duoshock/UM-70/README.md

# UM-70

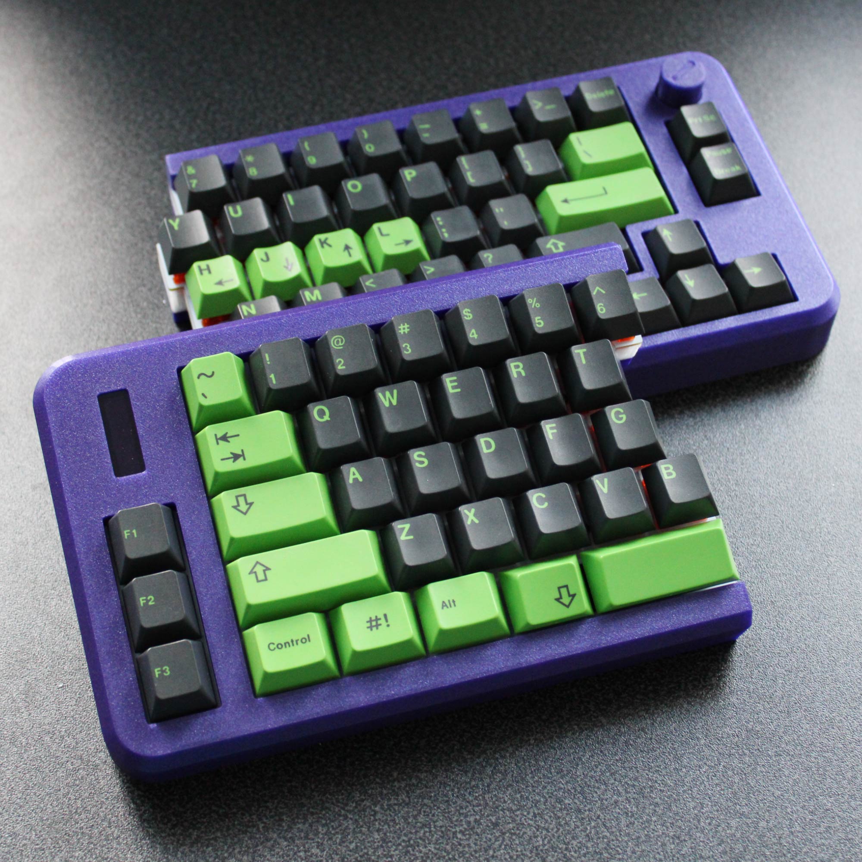
[picture p1: Assembly Guide/images/um70_extra_thumb.jpg]


UM-70 is a split keyboard in 65% layout with RGB, macro keys, OLED screen and encoder housed in PLA 3D printed cases sold by [Merge](https://mergedesign.store/products/um-70-r2).
