duoshock/UM-70/Print Guide/STLs/Cases/UM70_L_R2v1.STL

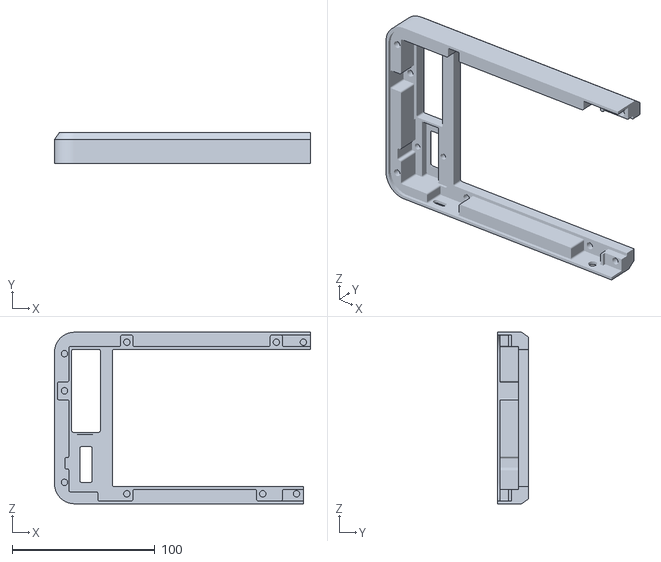
[picture p2: CAD file, 2022-07-18]
Print Guide/STLs/Cases/UM70_L_R2v1.STL
179.4 x 22.0 x 120.2
