duoshock/UM-70/Print Guide/STLs/Covers/UM70_R_Cover_R2v1.STL

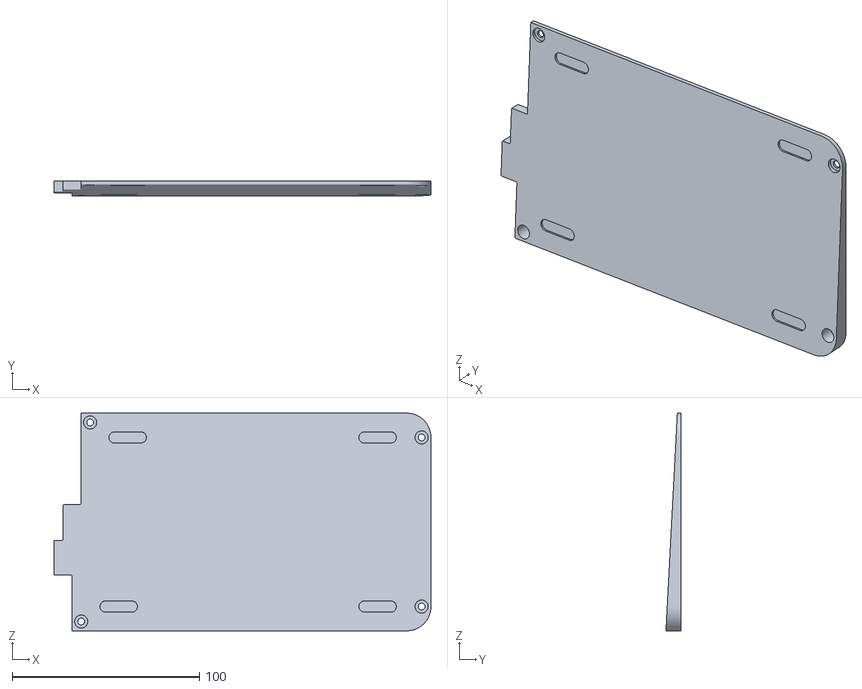
[picture p3: CAD file, 2022-10-08]
Print Guide/STLs/Covers/UM70_R_Cover_R2v1.STL
201.1 x 8.09 x 116.2
