duoshock/UM-70/Print Guide/STLs/Panels/UM70_L_Panel_R2v1.STL

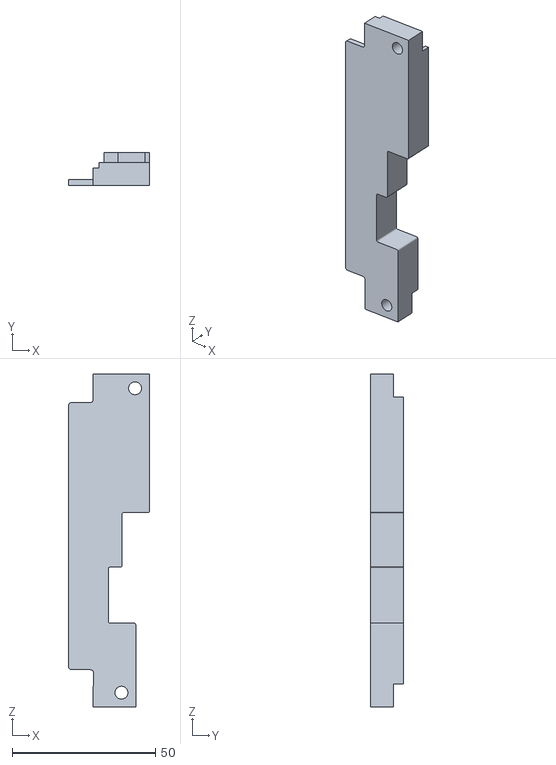
[picture p4: CAD file, 2022-10-08]
Print Guide/STLs/Panels/UM70_L_Panel_R2v1.STL
28.2 x 11.4 x 116.2
