duoshock/UM-70/Print Guide/STLs/Plates/UM70_L_Plate_v7.STEP

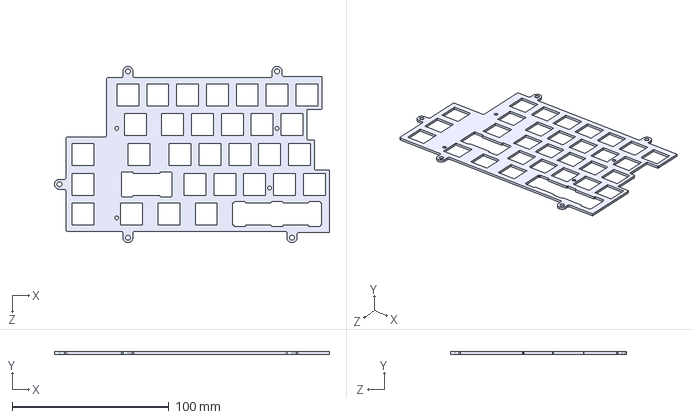
[picture p5: CAD file, 2023-09-09]
Print Guide/STLs/Plates/UM70_L_Plate_v7.STEP
175.6 x 1.60 x 112.6 mm
