duoshock/UM-70/Print Guide/STLs/Raisers - 4 Degree/UM70_L_Raiser_4Degree_R2v1.STL

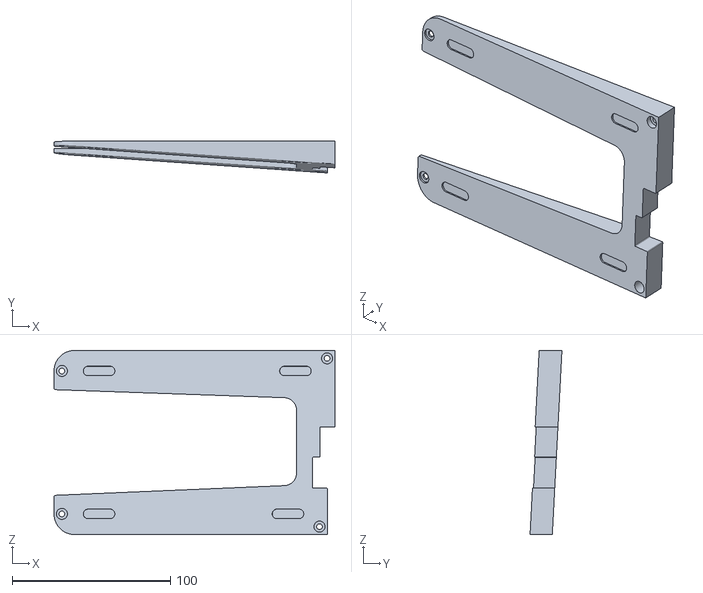
[picture p6: CAD file, 2022-10-08]
Print Guide/STLs/Raisers - 4 Degree/UM70_L_Raiser_4Degree_R2v1.STL
177.3 x 20.2 x 116.2
