duoshock/UM-70/Print Guide/STLs/Raisers - 6 Degree/UM70_R_Raiser_6Degree_R2v1.STL

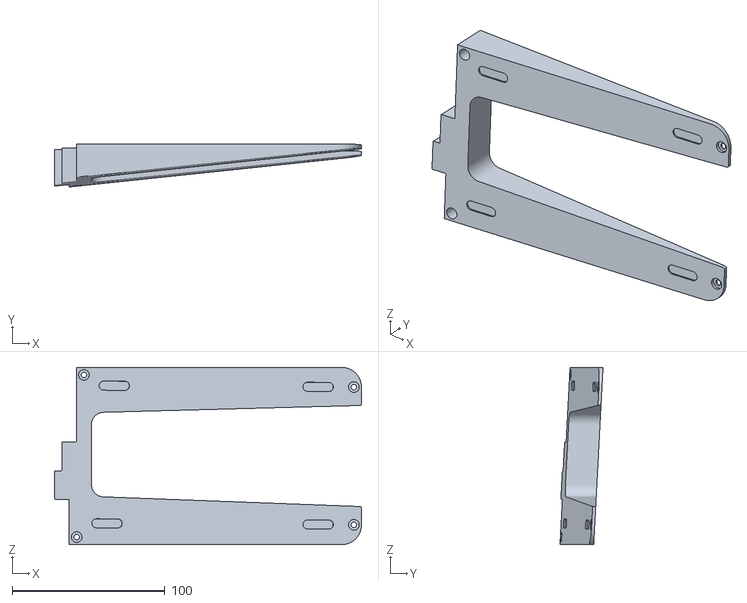
[picture p7: CAD file, 2022-10-08]
Print Guide/STLs/Raisers - 6 Degree/UM70_R_Raiser_6Degree_R2v1.STL
201.1 x 28.2 x 116.2
