duoshock/UM-70/Print Guide/STLs/UM70_Knob_v1.stl

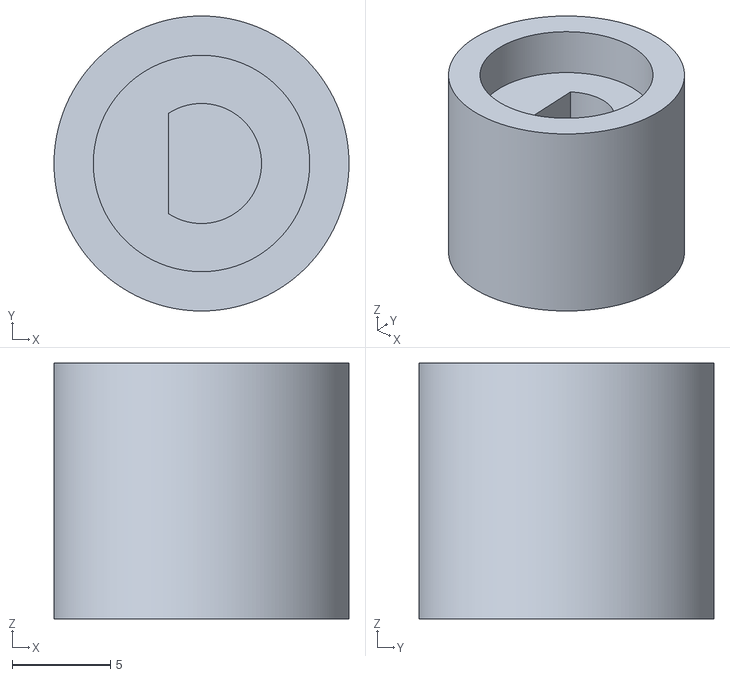
[picture p8: CAD file, 2025-07-31]
Print Guide/STLs/UM70_Knob_v1.stl
15.0 x 15.0 x 13.0
