duoshock/UM-70/Print Guide/STLs/Cases/UM70_R_R2v1.STL

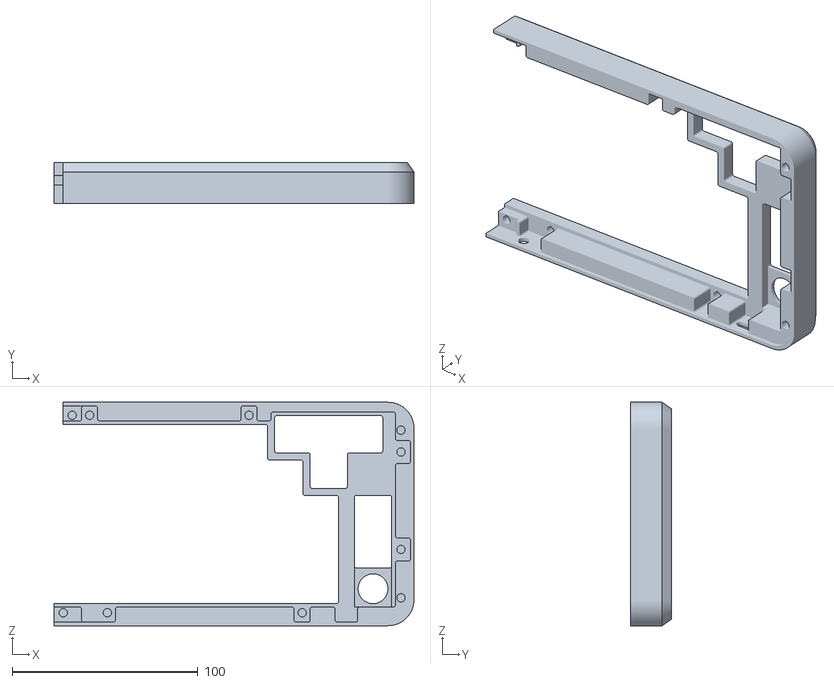
[picture p9: CAD file, 2022-07-18]
Print Guide/STLs/Cases/UM70_R_R2v1.STL
193.6 x 22.0 x 120.2
