duoshock/UM-70/Print Guide/STLs/Covers/UM70_L_Cover_R2v1.STL

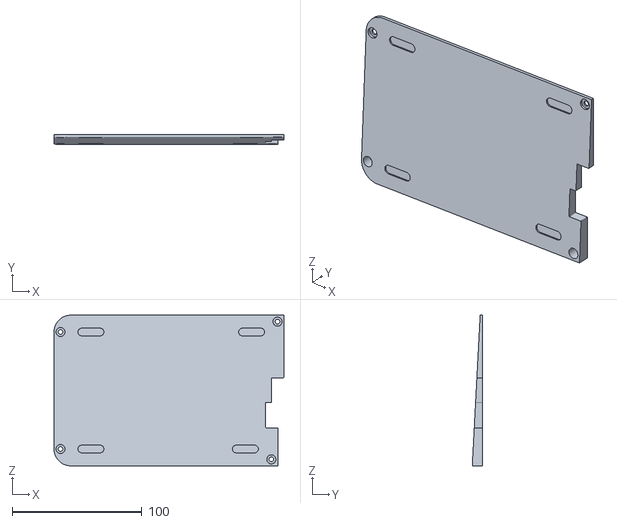
[picture p10: CAD file, 2022-10-08]
Print Guide/STLs/Covers/UM70_L_Cover_R2v1.STL
177.3 x 8.09 x 116.2
