duoshock/UM-70/Print Guide/STLs/Panels/UM70_R_Panel_R2v1.STL

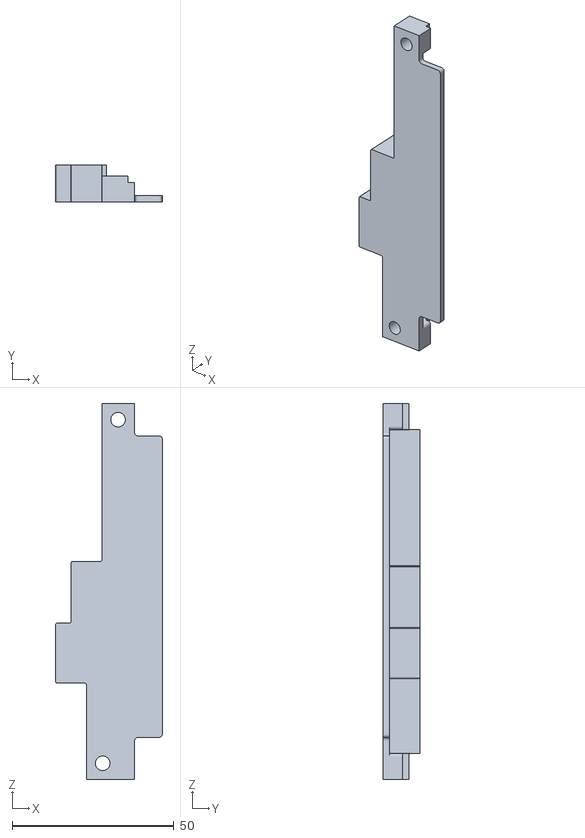
[picture p11: CAD file, 2022-10-08]
Print Guide/STLs/Panels/UM70_R_Panel_R2v1.STL
33.0 x 11.4 x 116.2
