duoshock/UM-70/Print Guide/STLs/Plates/UM70_R_Plate_v7.STEP

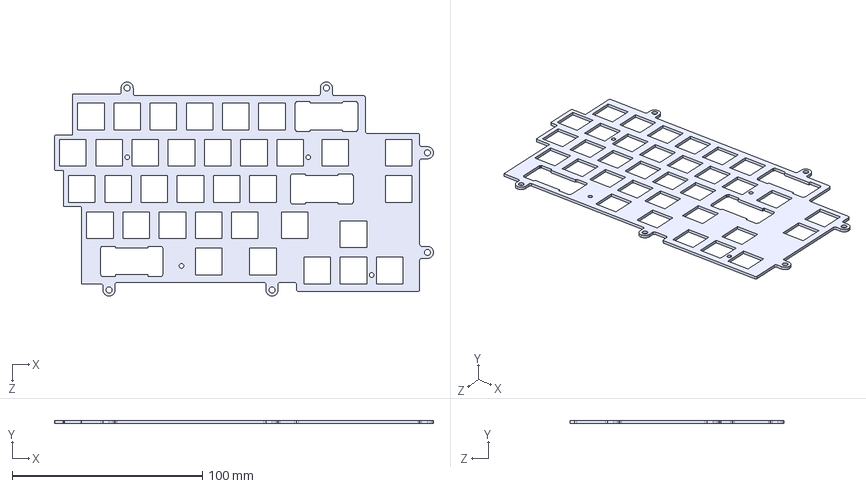
[picture p12: CAD file, 2023-09-09]
Print Guide/STLs/Plates/UM70_R_Plate_v7.STEP
199.3 x 1.60 x 112.6 mm
