duoshock/UM-70/Print Guide/STLs/Raisers - 4 Degree/UM70_R_Raiser_4Degree_R2v1.STL

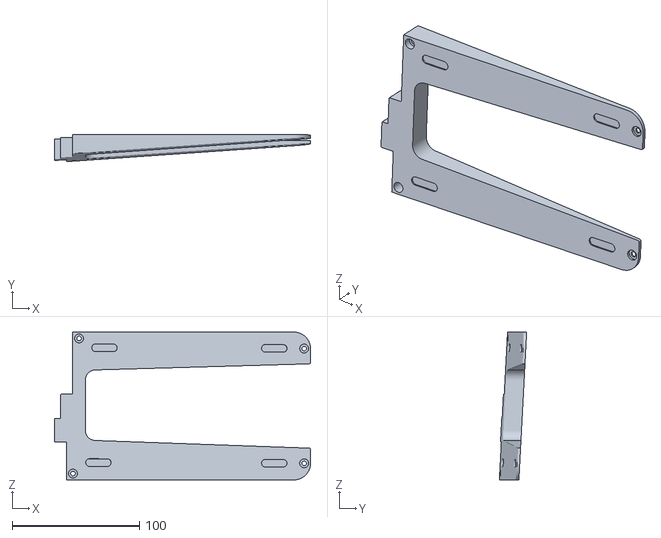
[picture p13: CAD file, 2022-10-08]
Print Guide/STLs/Raisers - 4 Degree/UM70_R_Raiser_4Degree_R2v1.STL
201.1 x 21.5 x 116.2
