duoshock/UM-70/Print Guide/STLs/Raisers - 6 Degree/UM70_L_Raiser_6Degree_R2v1.STL

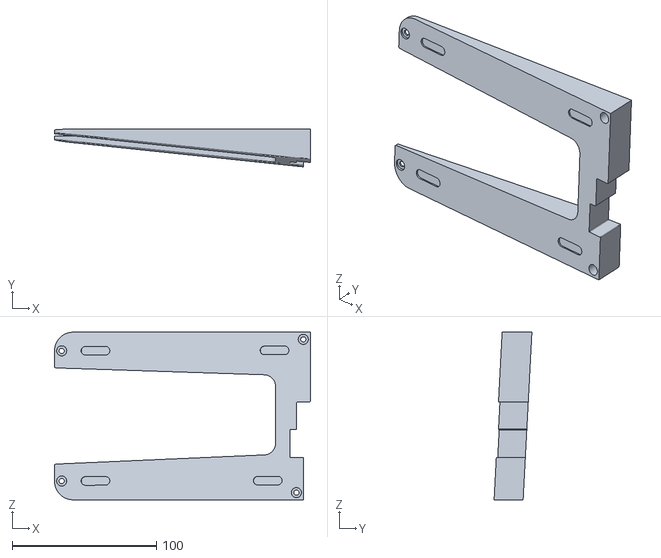
[picture p14: CAD file, 2022-10-08]
Print Guide/STLs/Raisers - 6 Degree/UM70_L_Raiser_6Degree_R2v1.STL
177.3 x 26.2 x 116.2
