duoshock/UM-70/Assembly Guide/Readme.md

# UM-70 Assembly Guide

## **Content of UM-70 Kit**

<a href="images/00_WhatsInTheBox.jpg">
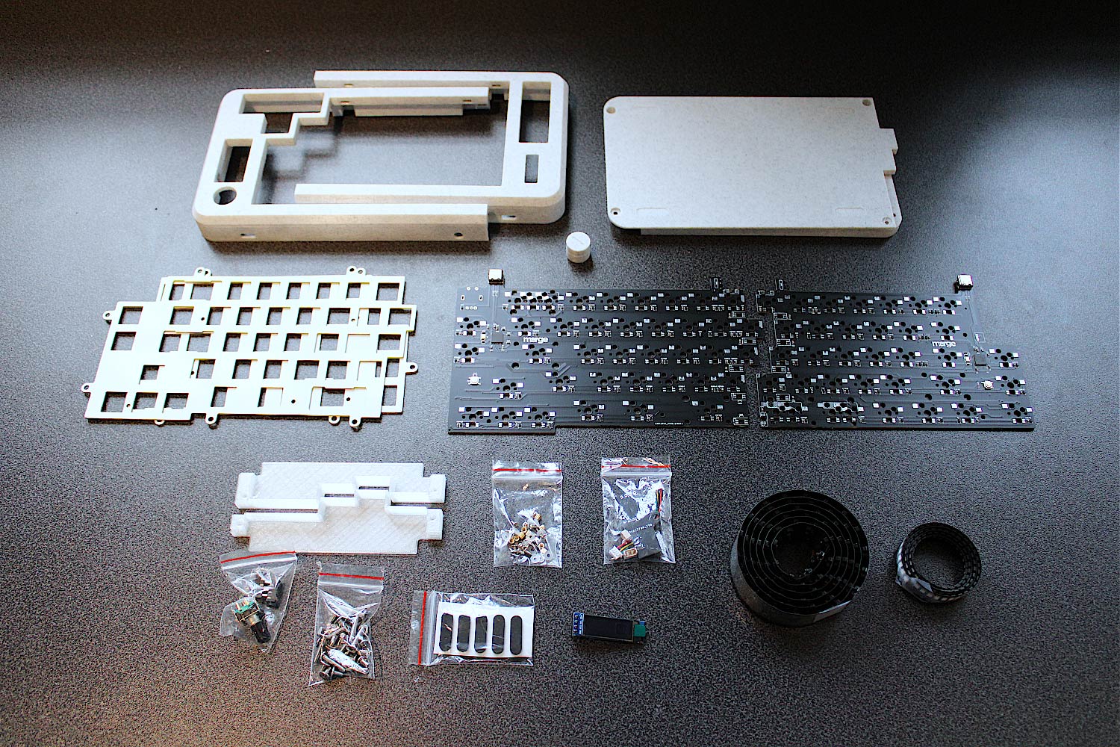
[picture p15: Assembly Guide/images/00_WhatsInTheBox.jpg]

</a>

**Housing** 
- 2 x Top Case
- 2 x Rear Cover
- 2 x Side Panel
- 1 x Rotary Encoder Knob

**Electronics**
- 1 x OLED Screen PCB
- 1 x OLED Screen
- 2 x 4 Pins Sockets
- 1 x 4 Pins Cable
- 1 x Encoder
- 100 x SK6812MINI RGB LED** (Only 84 are required)
- 80 x Hot swap sockets (Only 70/71 are required)
- 2 x TRRS PJ-320A

**Fasteners**
- 20 x M2 3mm screws
- 10 x M2 3mm Standoffs
- 10 x M2 washers
- 20 x M3 5mm screws
- 5 x M3 16mm screws
- 5 x M3 25mm screws

**Miscellaneous**
- 1 x FR4 Plates (Left & Right)
- 8 x Rubber feet

---

## **FAQ** ##

- **Why some keys are not registered on the right half when testing the PCB by connecting via USB cable?**

    The Left and right sides have a different key matrix (i.e. different number of keys). The pre-flashed firmware is set as master left, so when testing the right side via USB, the computer registers it as the left side which has less key than the right side.

    So it's normal to have some keys not registered on the right side when it is connected via USB. To perform a proper test, connect the right half via TRRS cable.

- **Why it disconnect when I plug in the TRRS cable?**

    TRRS cable carries data and power to the other half. When plugging the cable into the TRRS jack, the ring that carries power makes contact with the data pin and short the MCU. In most cases, the MCU will be fine after disconnecting the power, but something it can corrupts the EEPROM. In rare instance, kills the MCU. 

    *SO PLEASE DO NOT PLUG/UNPLUG TRRS CABLE WHEN POWER IS ON (I.E. WHEN USB CABLE IS CONNECTED).*

---

## **Test the PCBs before soldering**

<a href="images/01_Test.jpg">
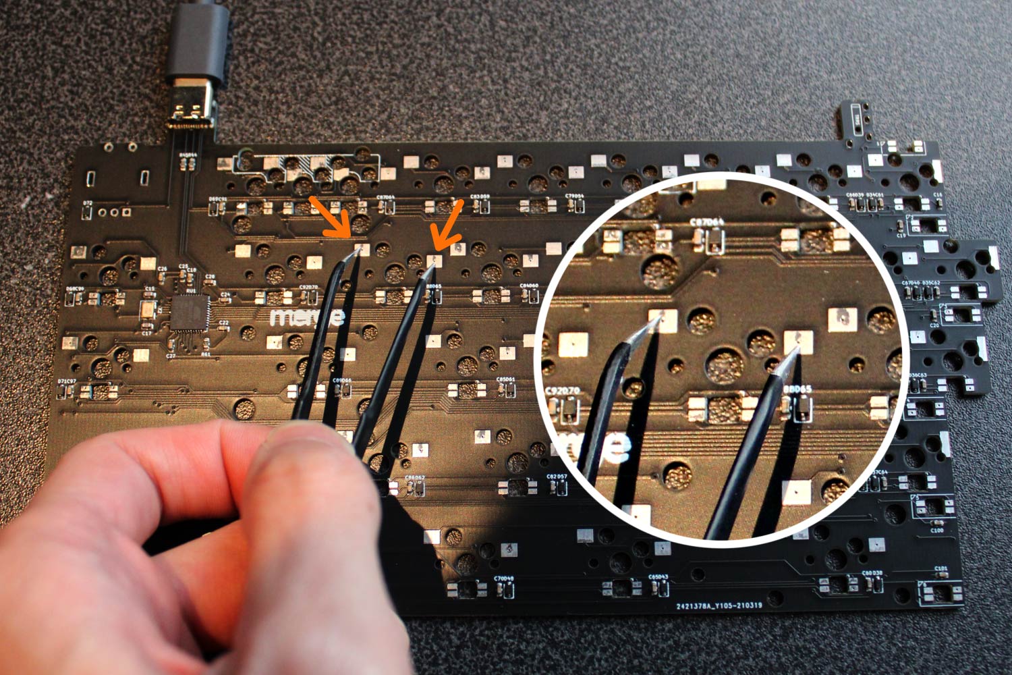
[picture p16: Assembly Guide/images/01_Test.jpg]

</a>

All PCBs are tested prior shipping, but it is good practice to make sure they are working before soldering. Both PCBs should be recognised as keyboard input device when connected to a computer. Plug in one half and test by shorting switch pins with tweezers. After testing one half, disconnect the first and test the other half. Don’t panic if the right side PCB outputs the wrong key for that switch location or not registers some of the keys, as the firmware is set to left as master. As long as both halves produce some output you have verified the PCBs are working.

## **Assembling the Main PCBs**

<a href="images/02_LEDs.jpg">
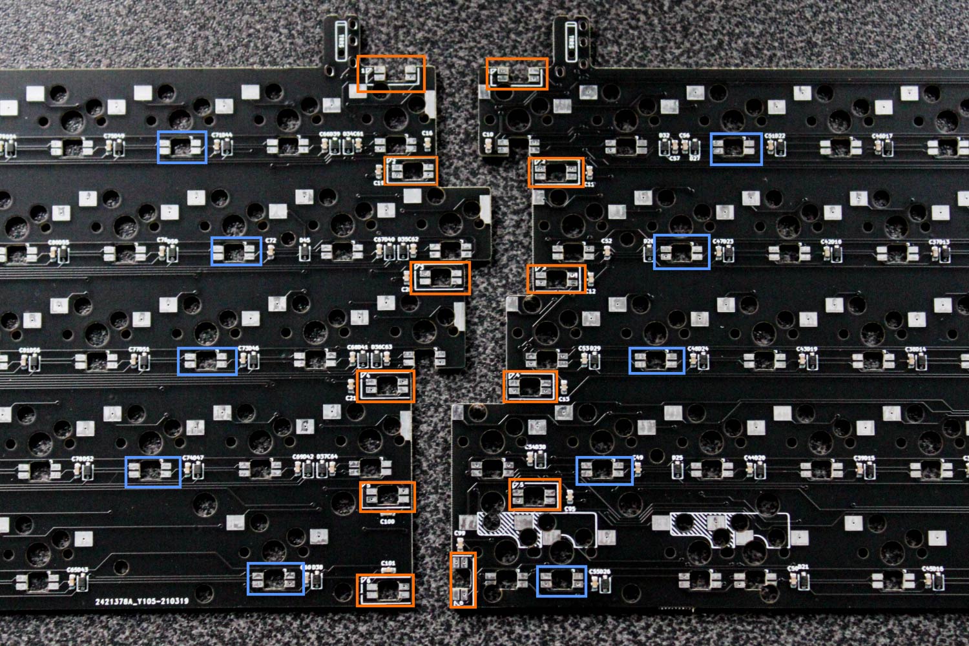
[picture p17: Assembly Guide/images/02_LEDs.jpg]

</a>

**_Blue = In-switch LEDs_**

**_Orange = Panel LEDs_**

There are 33 in-switch and 6 panel LEDs on the left half. 37 in-switch (38 for split backspace) and 6 panel LEDs on the right side.

## **Panel LEDs**

<a href="images/03_PanelLEDLens.jpg">
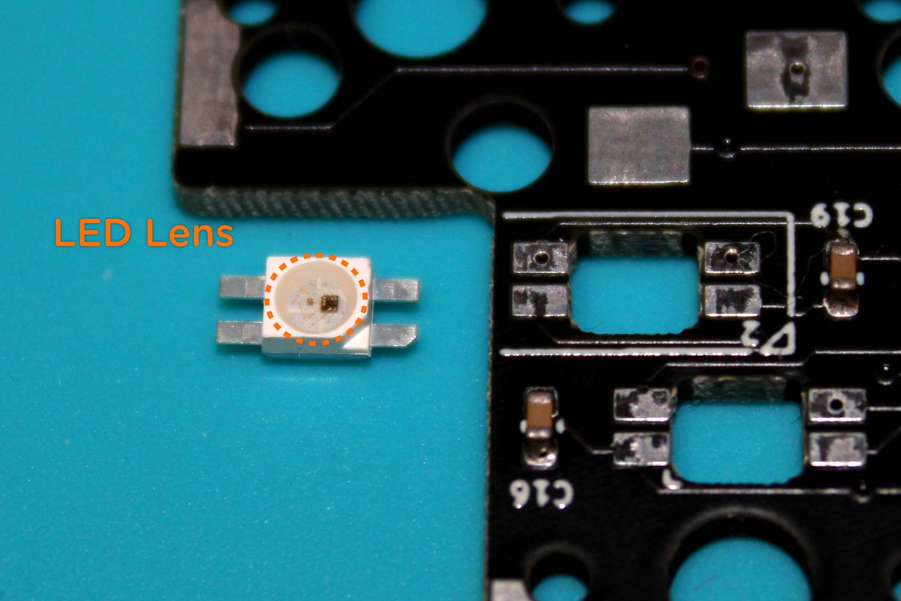
[picture p18: Assembly Guide/images/03_PanelLEDLens.jpg]

</a>

<a href="images/04_PenalLEDMarking.jpg">
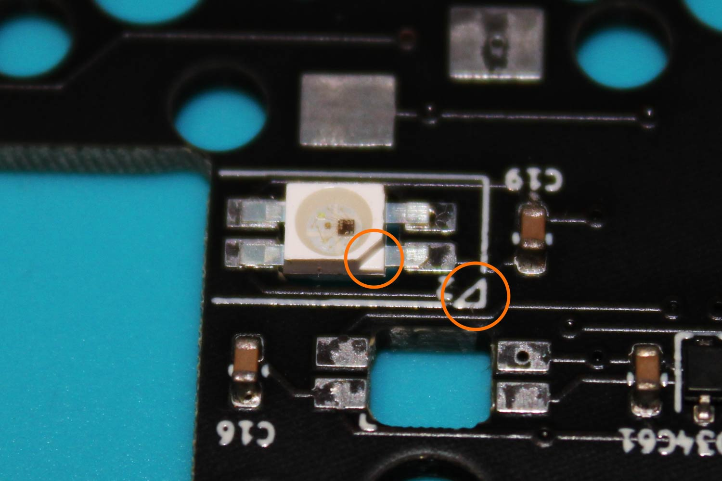
[picture p19: Assembly Guide/images/04_PenalLEDMarking.jpg]

</a>

To solder side panel LEDs, the LED lens should be facing up. Align the marking on the PCB and the LED then solder. Repeat the same process for the remaining side panel LEDs.

## **In-switch LEDs**

<a href="images/06_SwitchLEDMarking_A.jpg">
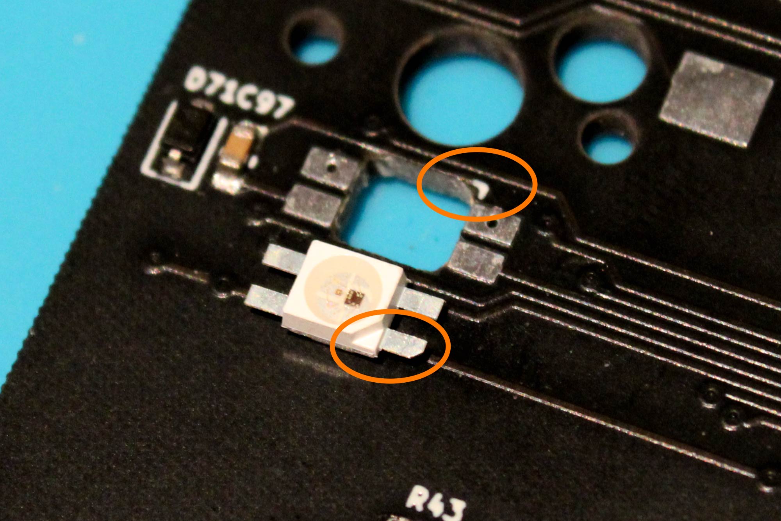
[picture p20: Assembly Guide/images/06_SwitchLEDMarking_A.jpg]

</a>

<a href="images/06_SwitchLED_B.jpg">
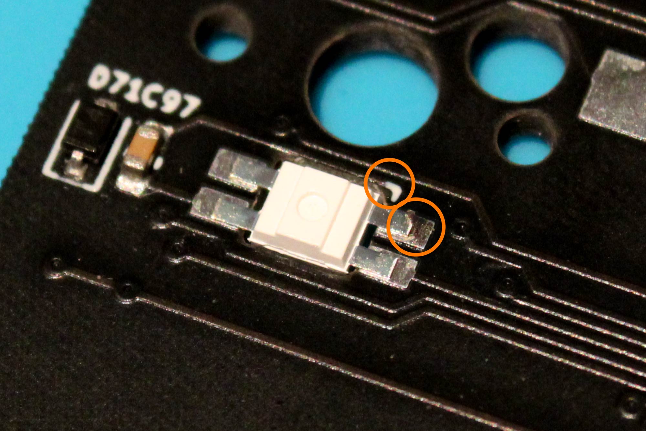
[picture p21: Assembly Guide/images/06_SwitchLED_B.jpg]

</a>

To solder in-switch LEDs, the LED lens should be facing down. Align the markings on the PCB and the LED then solder. Repeat the same process for the remaining in-switch LEDs.

<a href="images/07_Layout_Left.jpg">
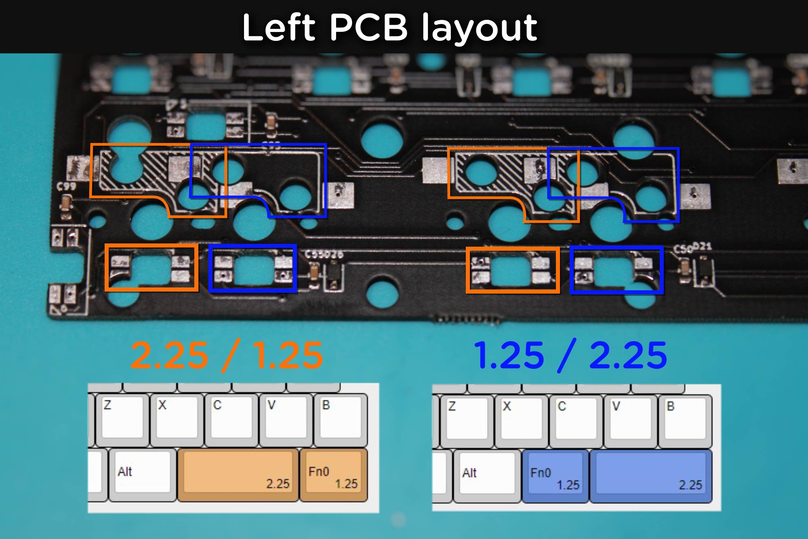
[picture p22: Assembly Guide/images/07_Layout_Left.jpg]

</a>

<a href="images/07_Layout_Right.jpg">
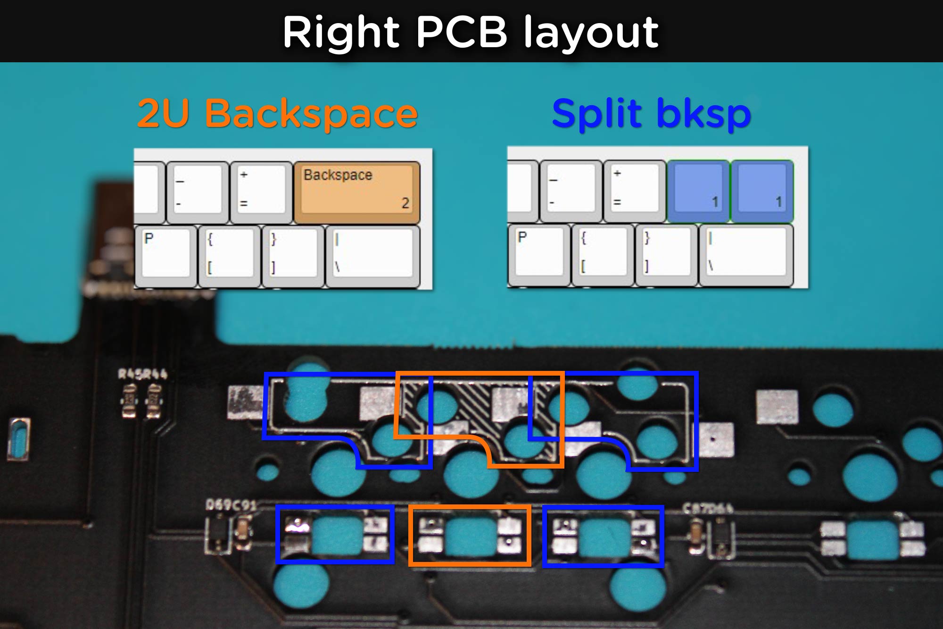
[picture p23: Assembly Guide/images/07_Layout_Right.jpg]

</a>

When soldering LEDs for Spacekey on the left and Backspace on the right, pick one of the two layouts shown above. Be sure to only solder one layout.

## **Hot swap sockets**
<a href="images/08_Hotswap_A.jpg">
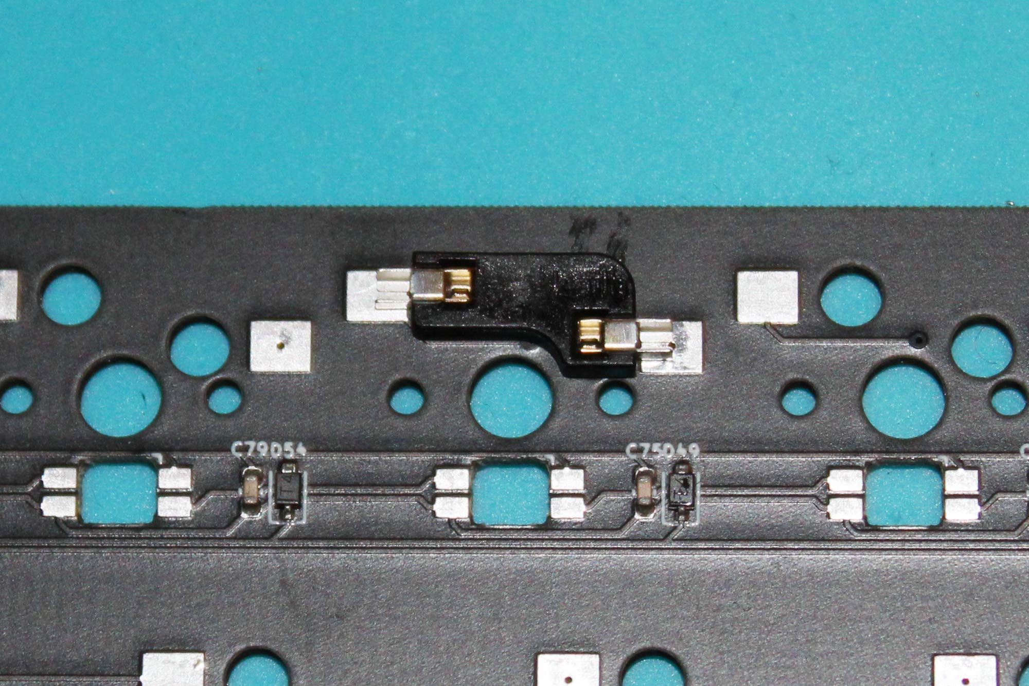
[picture p24: Assembly Guide/images/08_Hotswap_A.jpg]

</a>

Place sockets as shown in the photo. Note that you should solder from the underside of the PCB half you are working on. When soldering sockets for Spacekey on the left and Backspace on the right, refer to your chosen layout from the previous step for correct placement. Be sure to only solder sockets to one layout.

<a href="images/09_RightHowswap_A.jpg">
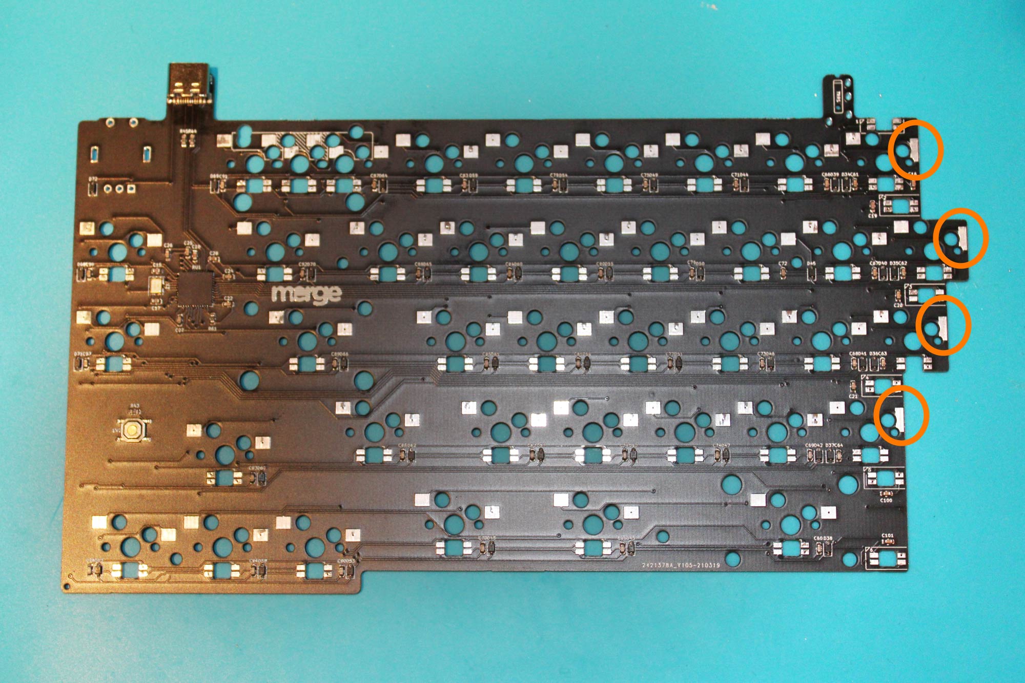
[picture p25: Assembly Guide/images/09_RightHowswap_A.jpg]

</a>

There are 4 sockets on the edge of the right half that need modification prior to soldering.

<a href="images/09_RightHowswap_B.jpg">
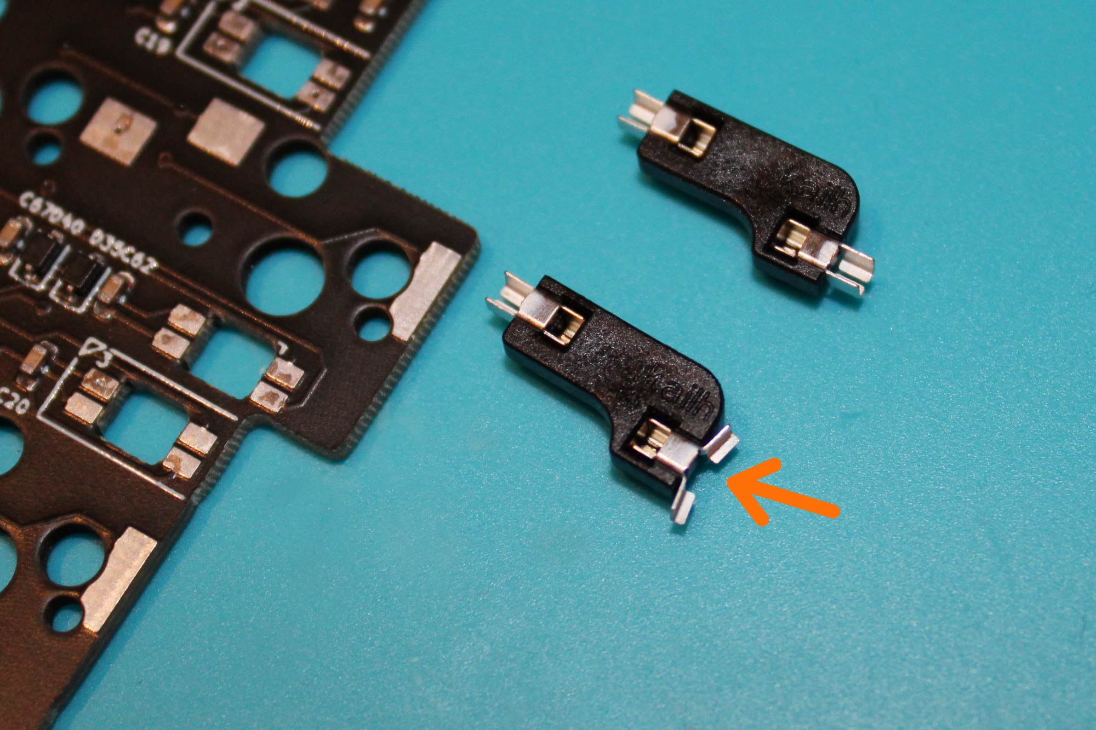
[picture p26: Assembly Guide/images/09_RightHowswap_B.jpg]

</a>
<a href="images/09_RightHowswap_C.jpg">
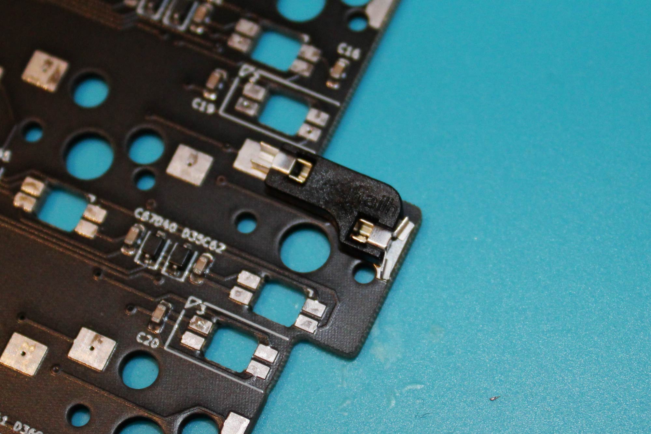
[picture p27: Assembly Guide/images/09_RightHowswap_C.jpg]

</a>

Spread the right pins of the socket as shown in the photo and then solder.

## **TRRS Jacks**
<a href="images/10_TRRS_A.jpg">
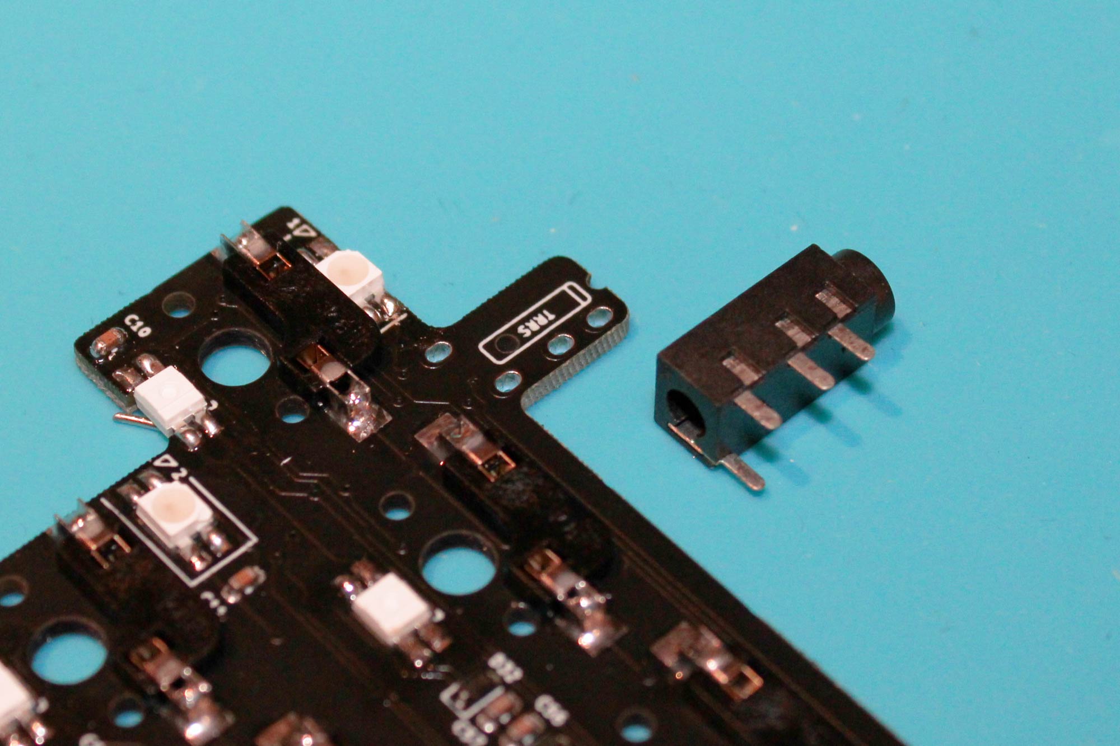
[picture p28: Assembly Guide/images/10_TRRS_A.jpg]

</a>
<a href="images/10_TRRS_B.jpg">
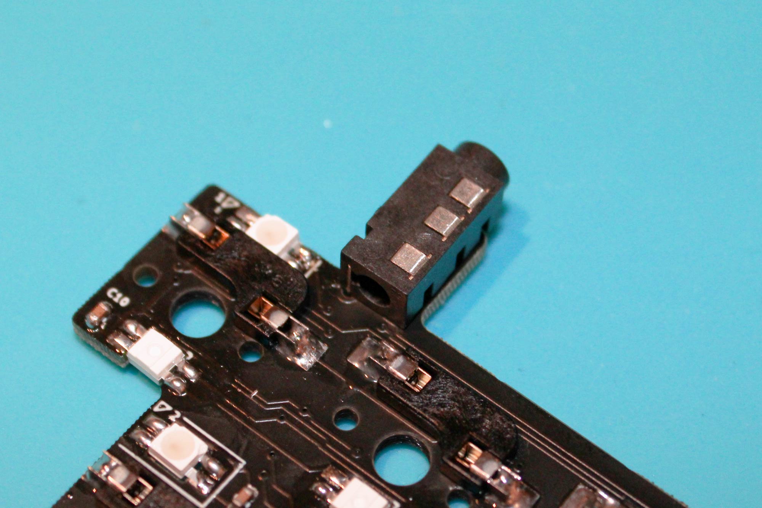
[picture p29: Assembly Guide/images/10_TRRS_B.jpg]

</a>

Place the jack on the underside of the PCB (the same side you just soldered sockets to) then solder.

## **OLED Screen Connector**
<a href="images/11_OLEDSocket_A.jpg">
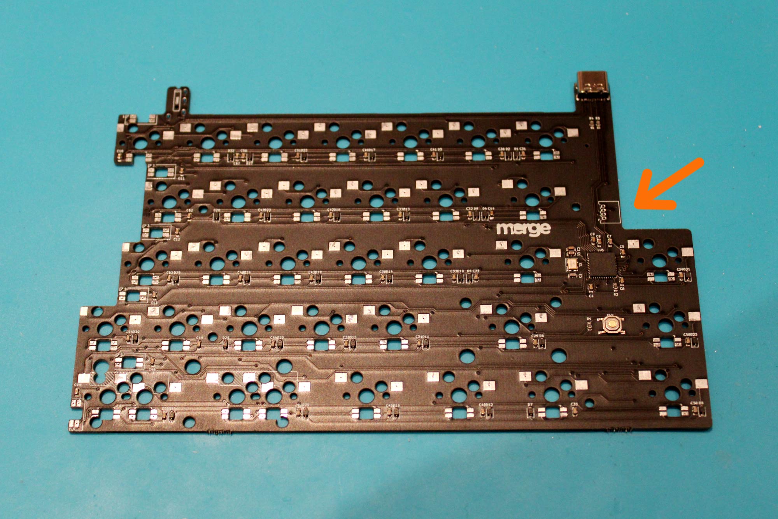
[picture p30: Assembly Guide/images/11_OLEDSocket_A.jpg]

</a>

OLED screen connector is located on the left half.

<a href="images/11_OLEDSocket_B.jpg">
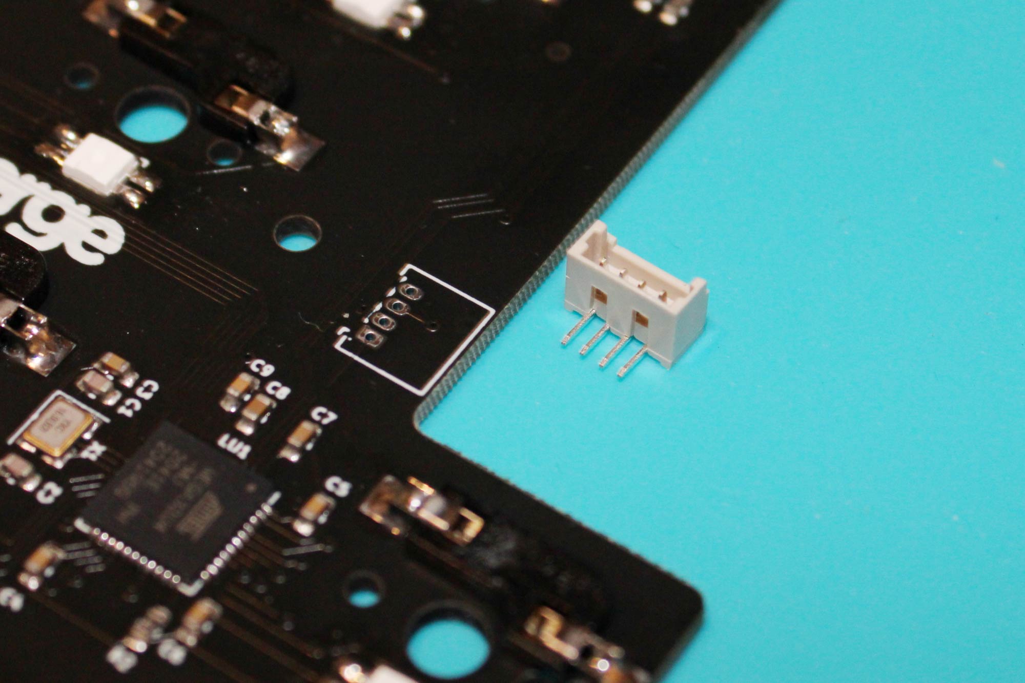
[picture p31: Assembly Guide/images/11_OLEDSocket_B.jpg]

</a>
<a href="images/11_OLEDSocket_C.jpg">
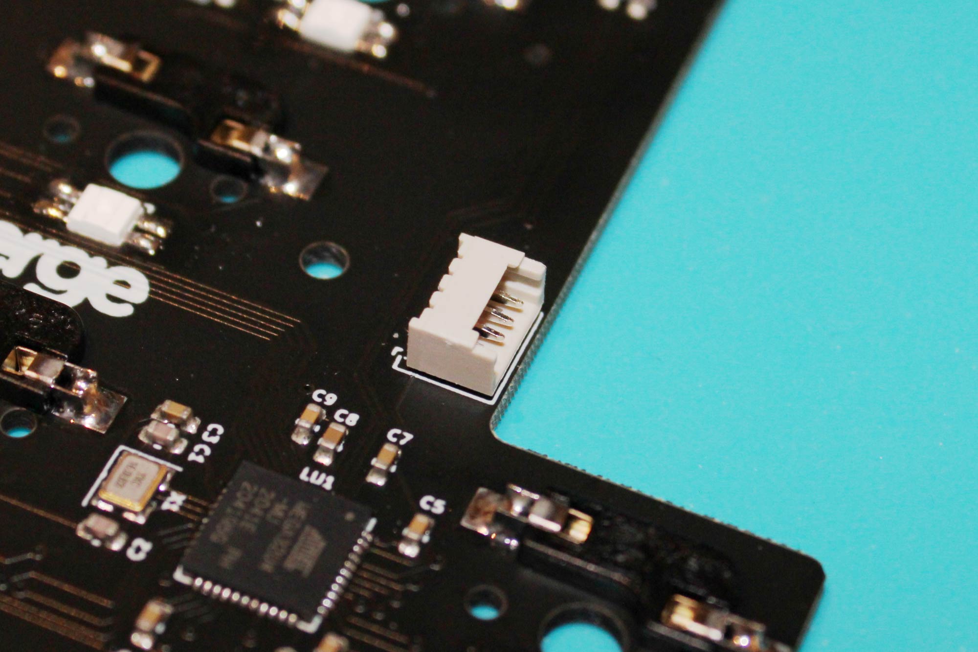
[picture p32: Assembly Guide/images/11_OLEDSocket_C.jpg]

</a>

Insert it on the underside of the PCB and then solder.

## **Buzzer**
_Optional, AST1109MLTRQ buzzer is not included in the kit_

<a href="images/12_Buzzer_A_L.jpg">
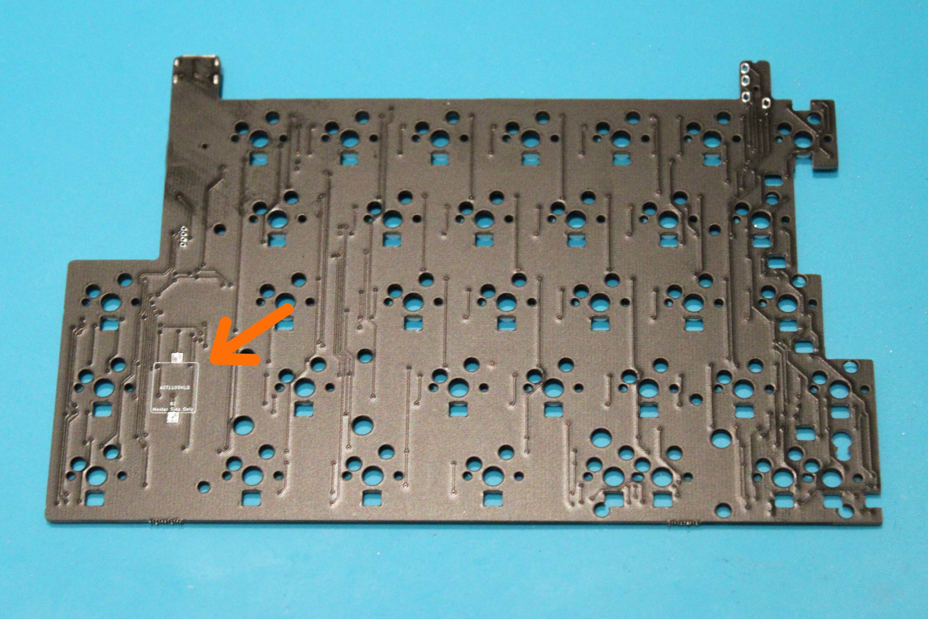
[picture p33: Assembly Guide/images/12_Buzzer_A_L.jpg]

</a>
<a href="images/12_Buzzer_A_R.jpg">
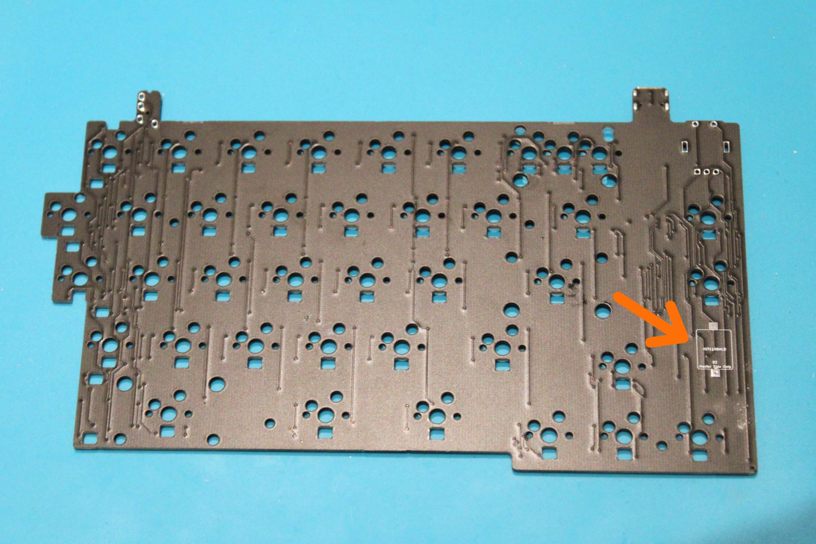
[picture p34: Assembly Guide/images/12_Buzzer_A_R.jpg]

</a>

Buzzers are located on the top sides of each PCB. Only solder a buzzer on the master half (Left half by default. Note that this can be changed. Be sure to solder the buzzer to the half that will be plugged into your PC via USB-C).

- _Audio is not enabled by default._

- _QMK does not support speaker on the on slave half._

- _Audio features take a large amount of memory, some other features may have to be disabled to allow space for it._

- _Buzzer is wired to IO pin B6._

<a href="images/12_Buzzer_B.jpg">
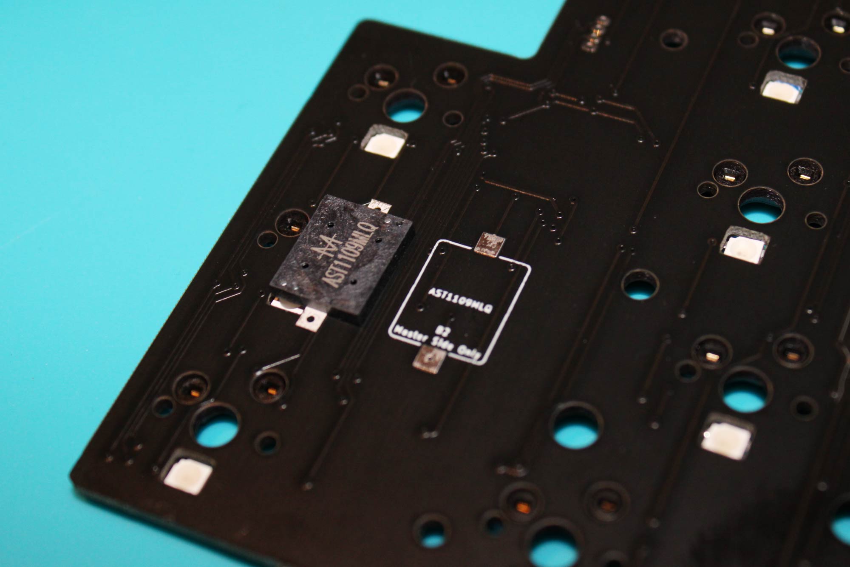
[picture p35: Assembly Guide/images/12_Buzzer_B.jpg]

</a>
<a href="images/12_Buzzer_C.jpg">
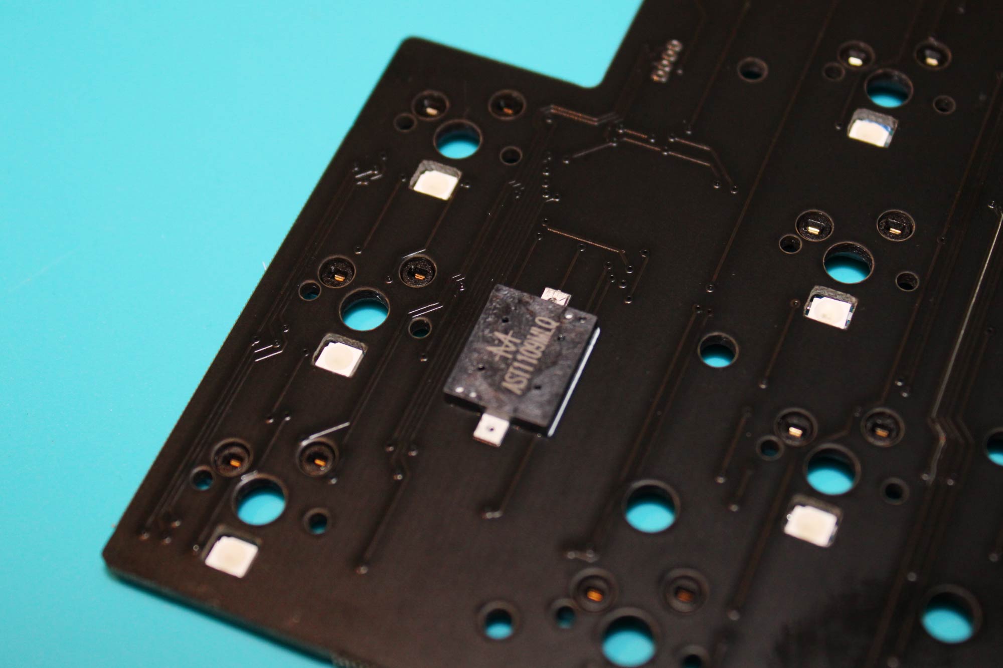
[picture p36: Assembly Guide/images/12_Buzzer_C.jpg]

</a>

AST1109MLRQ is non-polarity, solder anyway up.

---
## **Test the PCBs**

Connect both halves with TRRS cable **_first_**, and then connect USB cable to the **_left_** **_half_**.

**DO NOT PLUG/UNPLUG TRRS CABLE WHEN POWER IS ON (I.E. WHEN USB CABLE IS CONNECTED), IT CAN SHORT THE CONTROLLER.**

Check that all LEDs are working before proceeding to the next step.

### **Troubleshooting LEDs**

<a href="images/14_LEDOrder_L.jpg">
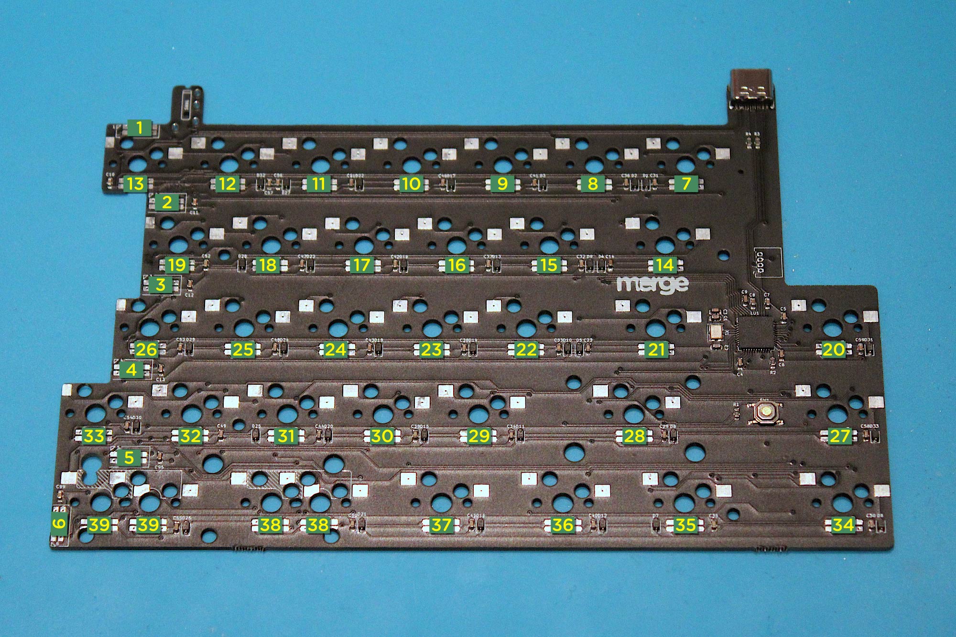
[picture p37: Assembly Guide/images/14_LEDOrder_L.jpg]

</a>
<a href="images/14_LEDOrder_R.jpg">
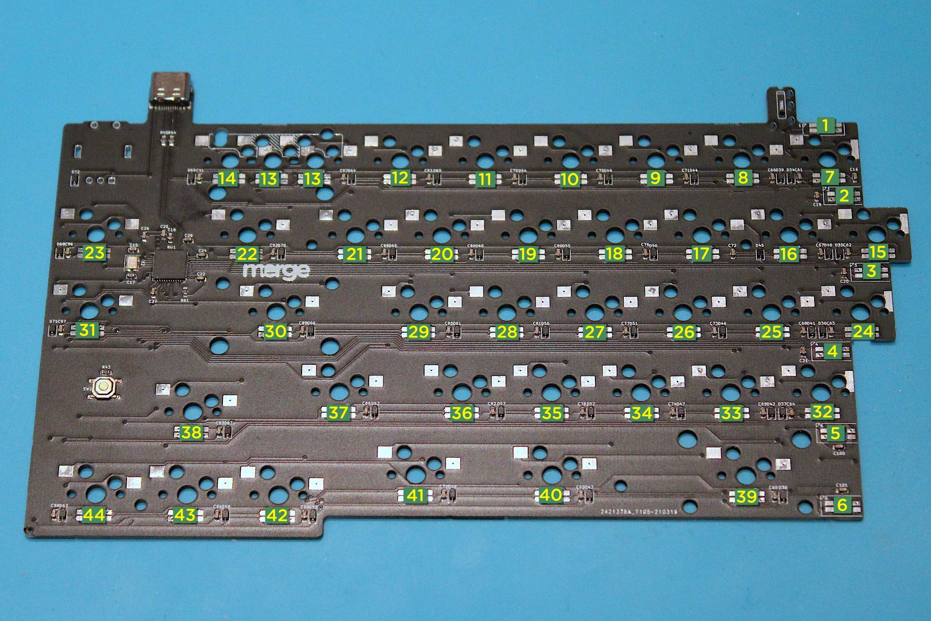
[picture p38: Assembly Guide/images/14_LEDOrder_R.jpg]

</a>

The LEDs are wired in series, see photos for the order.

If some of the LEDs do not light up or appear to be faulty, it’s most likely that something is wrong with the earliest LED in the series.
For example, if LED 24-39 doesn’t light up, check LED 24.
- Check solder joints

- Make sure there is a capacitor, it may have got knocked off during handling

- It’s not unusual to encounter a faulty RGB LED, replace it.

Once all LEDs are working, move on to the next step

---

## **Encoder**
<a href="images/13_Encoder_A.jpg">
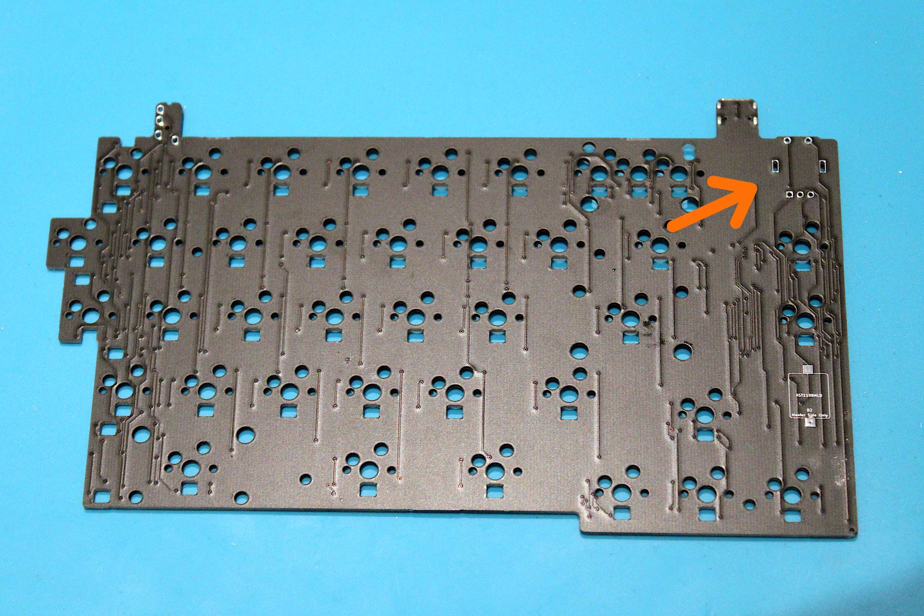
[picture p39: Assembly Guide/images/13_Encoder_A.jpg]

</a>

Encoder is located on the right half.

<a href="images/13_Encoder_B.jpg">
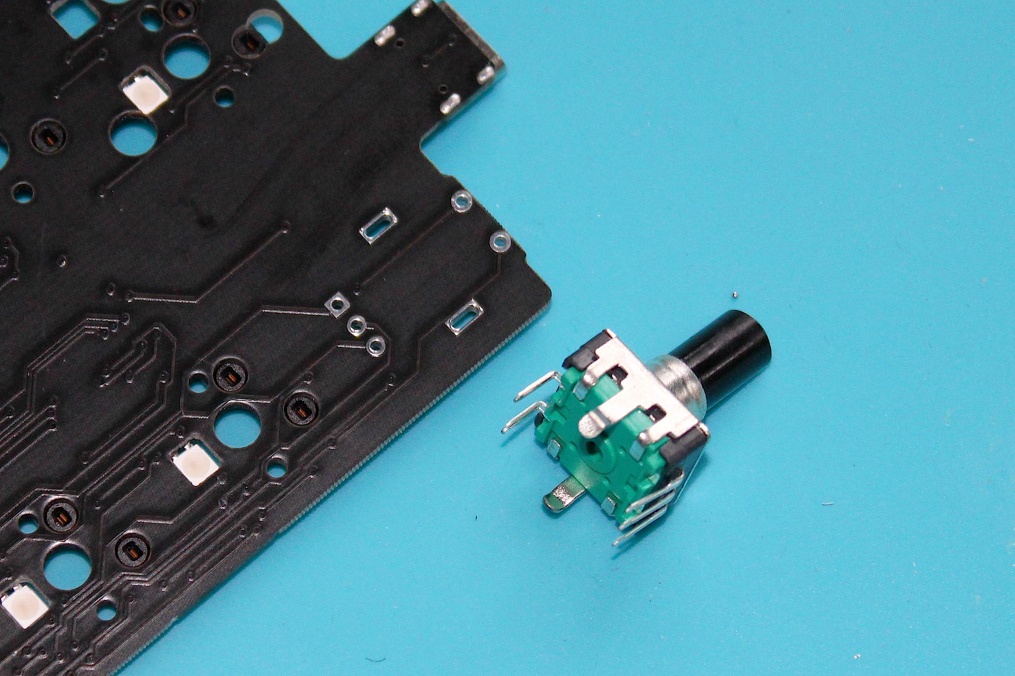
[picture p40: Assembly Guide/images/13_Encoder_B.jpg]

</a>
<a href="images/13_Encoder_C.jpg">
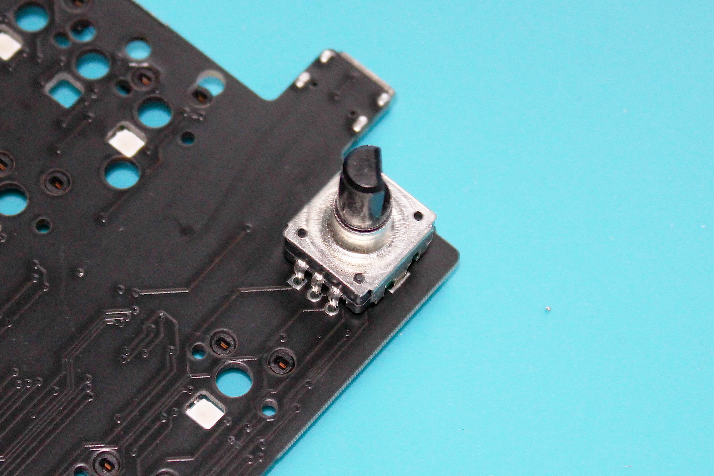
[picture p41: Assembly Guide/images/13_Encoder_C.jpg]

</a>

Insert encoder to the front of the PCB, solder it from the underside of the PCB.

## **Stabilisers**

<a href="images/Stab_A.jpg">
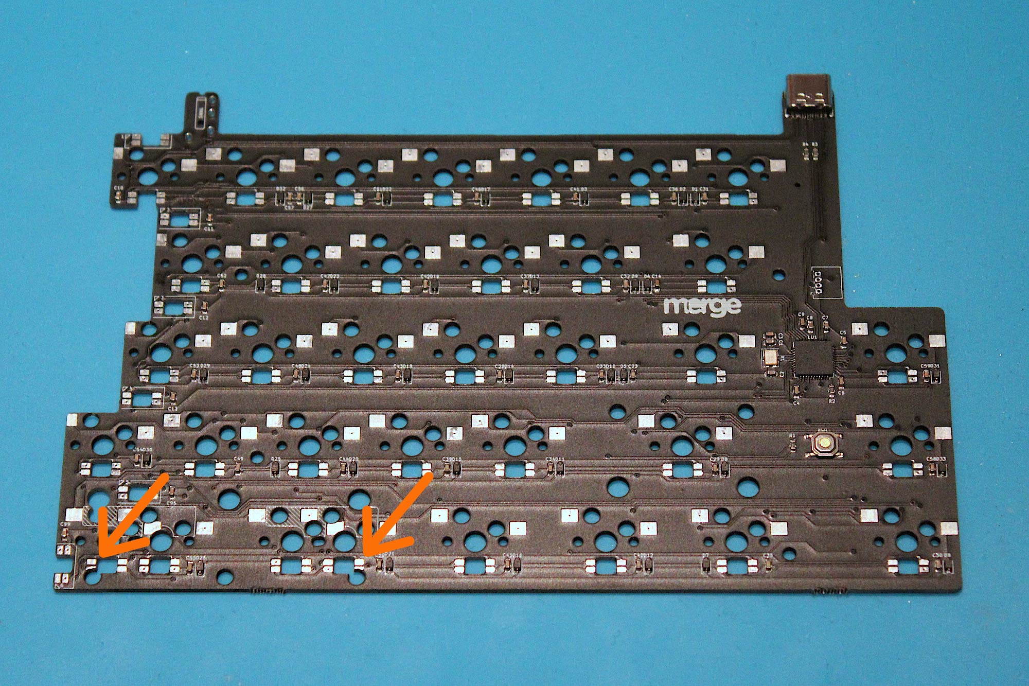
[picture p42: Assembly Guide/images/Stab_A.jpg]

</a>
<br>
<a href="images/Stab_B.jpg">
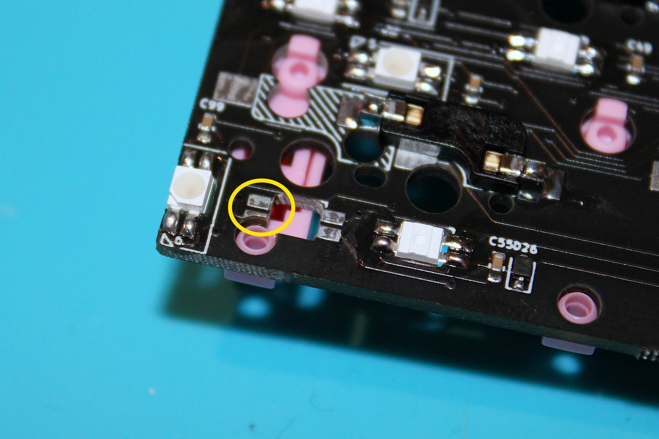
[picture p43: Assembly Guide/images/Stab_B.jpg]

</a>
<a href="images/Stab_C.jpg">
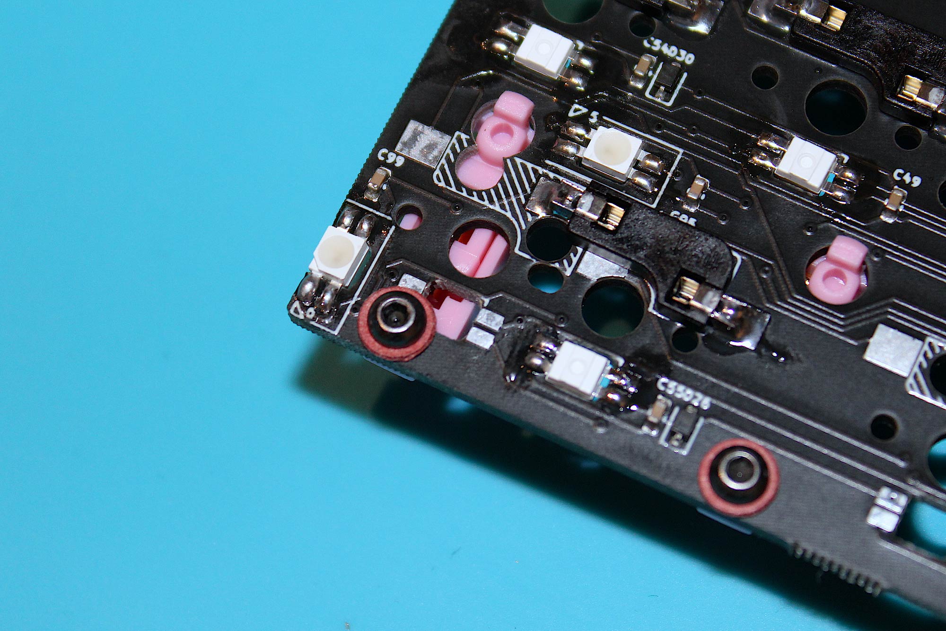
[picture p44: Assembly Guide/images/Stab_C.jpg]

</a>

When installing screw-in stabiliser for Spacekey on the left half, use a washer/electrical tape to isolate the screw and the LED contacts to prevent shorting.

## **Mounting PCB to plate**

<a href="images/PlateMountL_v2.jpg">
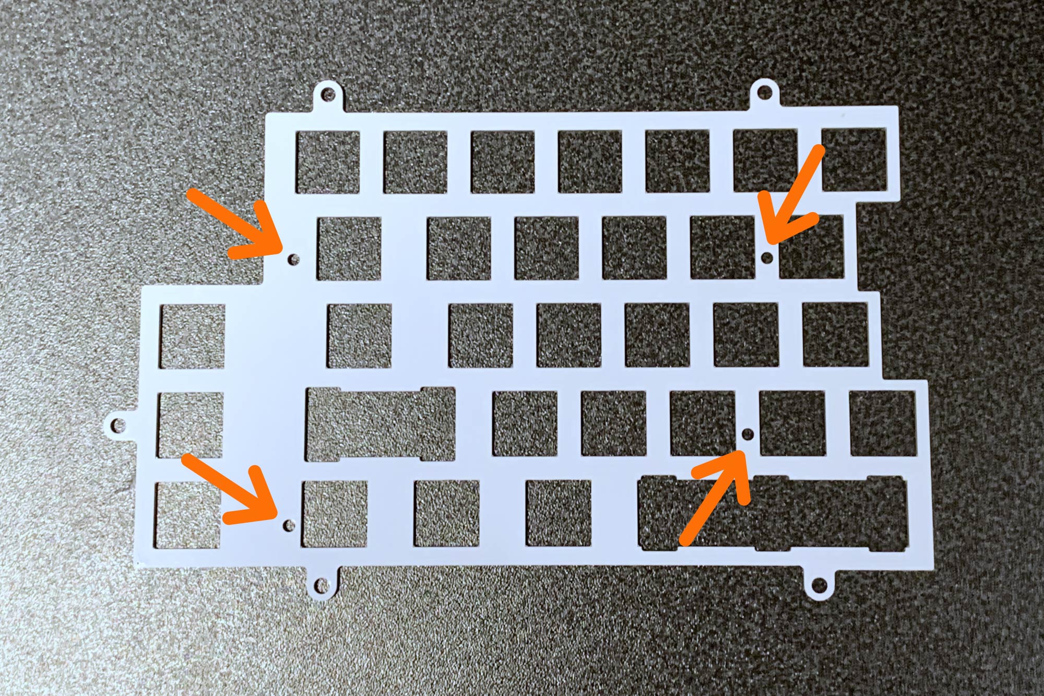
[picture p45: Assembly Guide/images/PlateMountL_v2.jpg]

</a>
<a href="images/PlateMountR_v2.jpg">
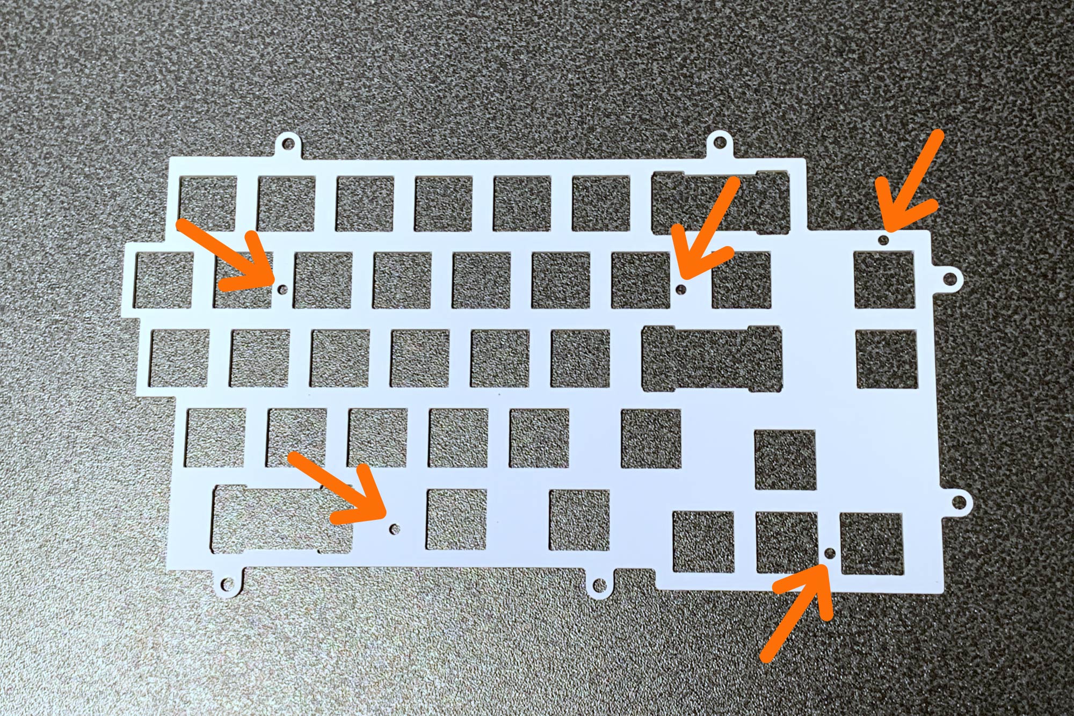
[picture p46: Assembly Guide/images/PlateMountR_v2.jpg]

</a>

There are 4 mounting points on the left side and 5 points on the right side.

<a href="images/StandOff_A_v2.jpg">
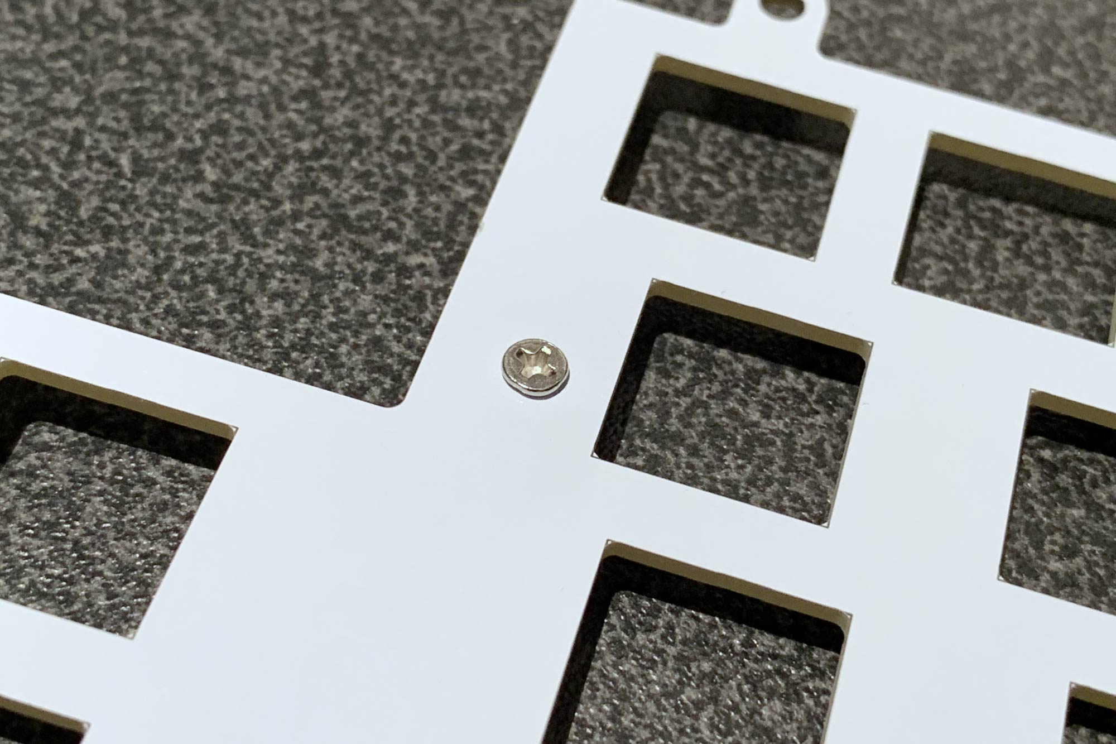
[picture p47: Assembly Guide/images/StandOff_A_v2.jpg]

</a>
<a href="images/StandOff_B_v2.jpg">
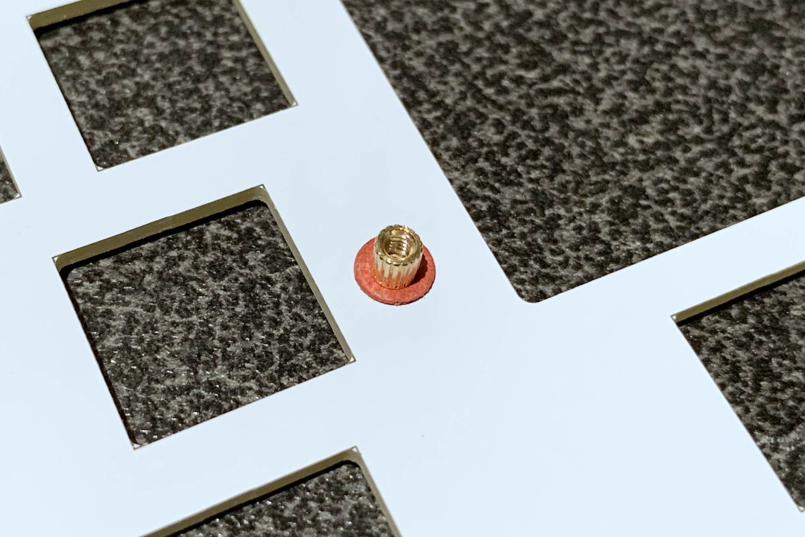
[picture p48: Assembly Guide/images/StandOff_B_v2.jpg]

</a>

Secure the standoffs to the plate with washers and M2 screws.

<a href="images/Switch_B.jpg">
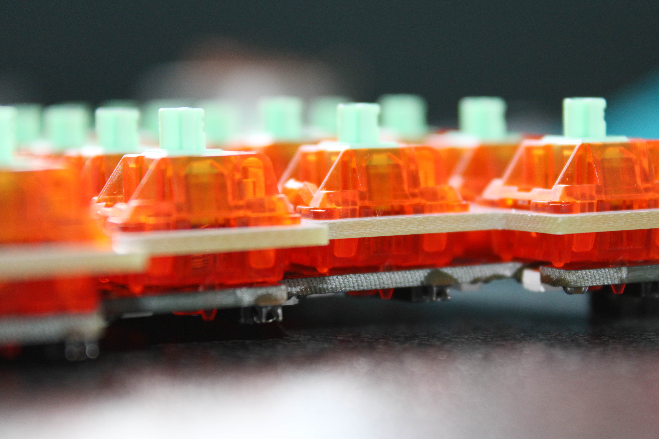
[picture p49: Assembly Guide/images/Switch_B.jpg]

</a>

Insert switches to plate and PCB. Switches should seat flush on the PCB. 

<a href="images/PCBMountholes_L.jpg">
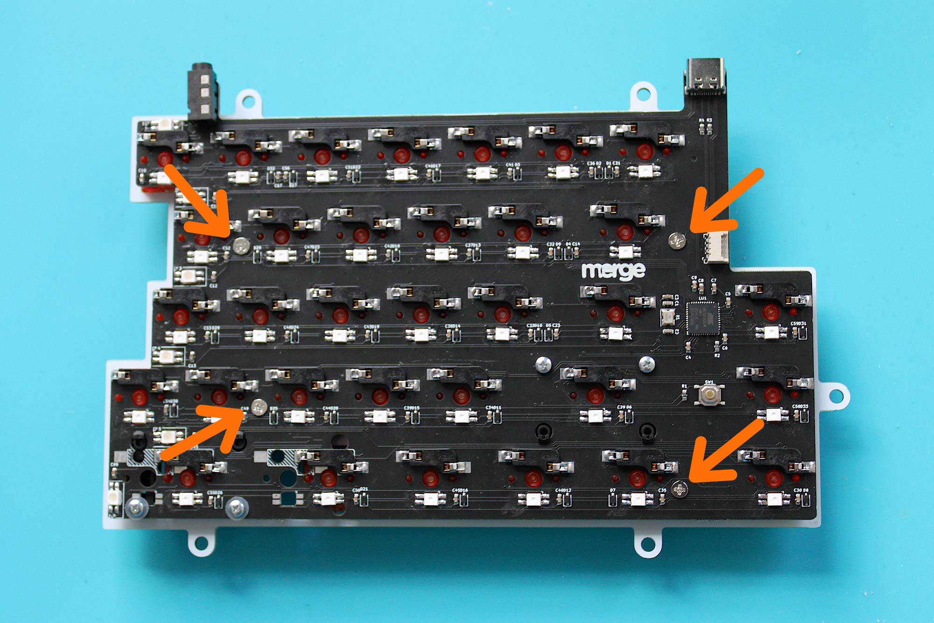
[picture p50: Assembly Guide/images/PCBMountholes_L.jpg]

</a>
<a href="images/PCBMountholes_R_V2-2.jpg">
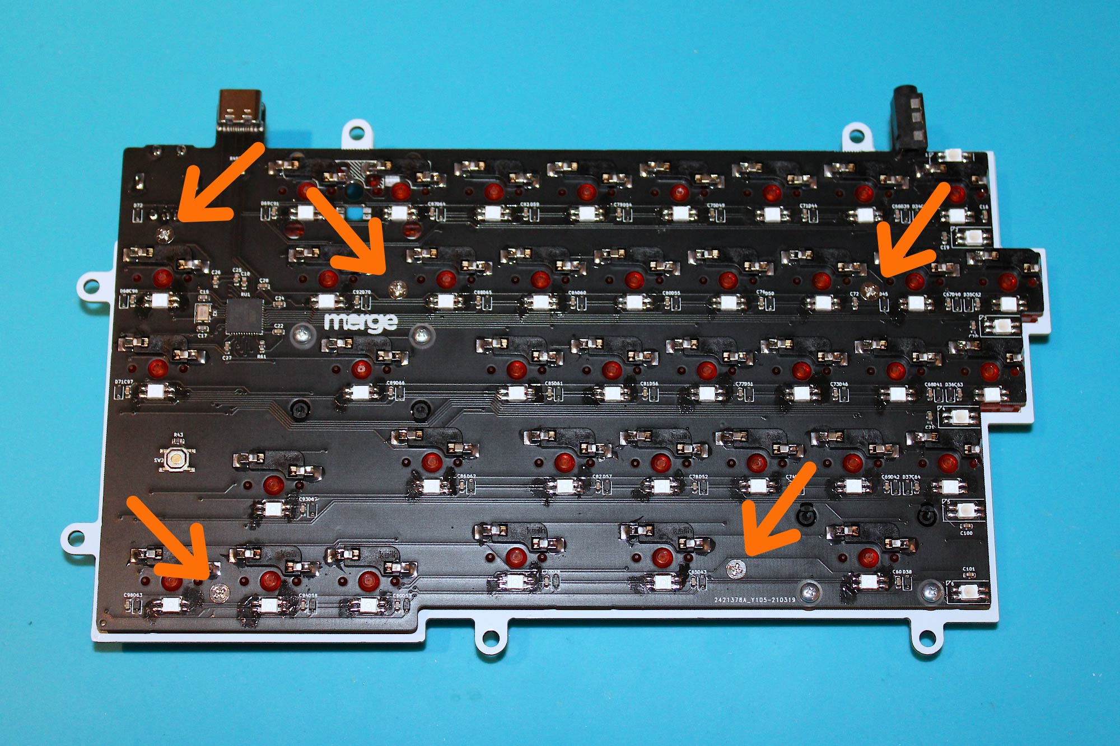
[picture p51: Assembly Guide/images/PCBMountholes_R_V2-2.jpg]

</a>

Secure PCB to plate with M2 screws. 

---
## **Test the PCBs**

Connect both halves with TRRS cable **_first_**, and then connect USB cable to the **_left_** **_half_**.

**DO NOT PLUG/UNPLUG TRRS CABLE WHEN POWER IS ON (I.E. WHEN USB CABLE IS CONNECTED), IT WILL SHORT THE CONTROLLER.**

Confirm that all switches and the encoder are working before proceeding to the next step.

### **Troubleshooting Encoder/Switches**

**Encoder**
- Check solder joints.
- Make sure there is a diode, it may have got knocked off during handling.

**Switches**
- Dismount the switch and check for bent pins, straighten the pins with pliers if necessary.
- Check hot swap socket solder joints.
- Check for diode on near the switch, it may have got knocked off during handling.

---

## **Soldering OLED screen PCB**

<a href="images/15_OLED_PCB.jpg">
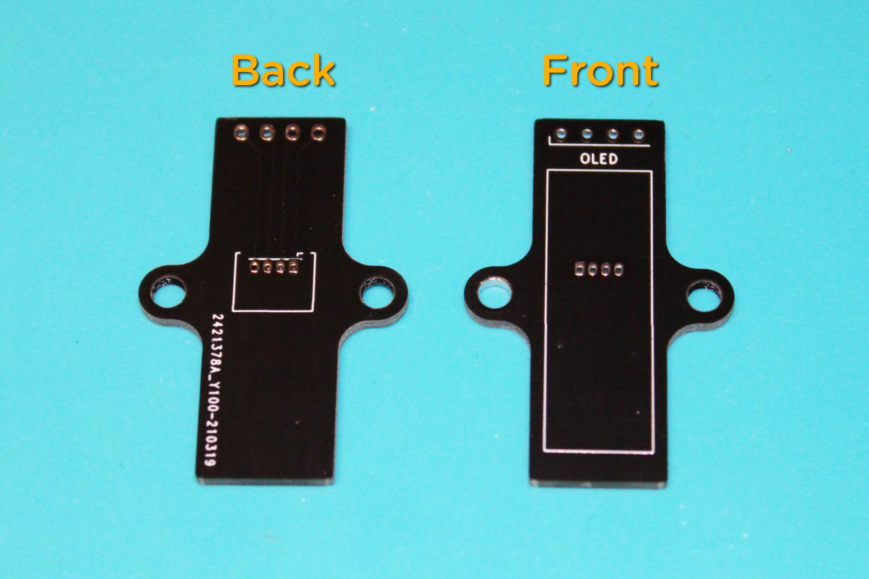
[picture p52: Assembly Guide/images/15_OLED_PCB.jpg]

</a>

Note the front and back of the PCB

<a href="images/16_OLED_Conn_A.jpg">
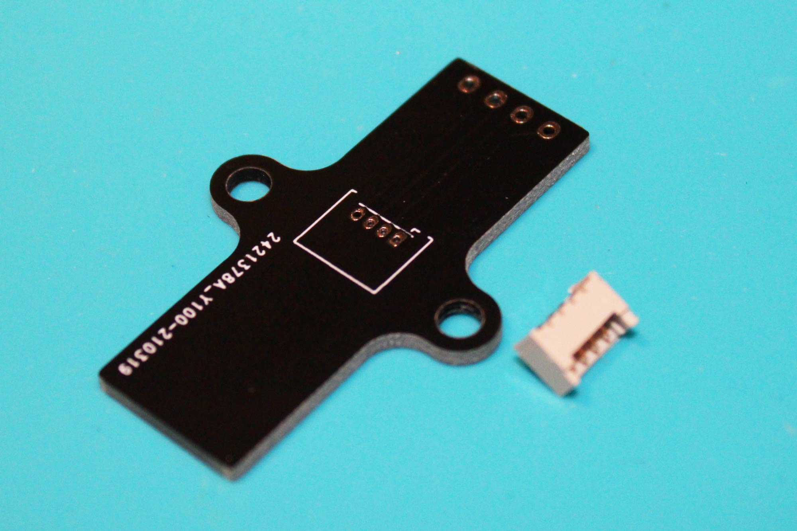
[picture p53: Assembly Guide/images/16_OLED_Conn_A.jpg]

</a>
<a href="images/16_OLED_Conn_B.jpg">
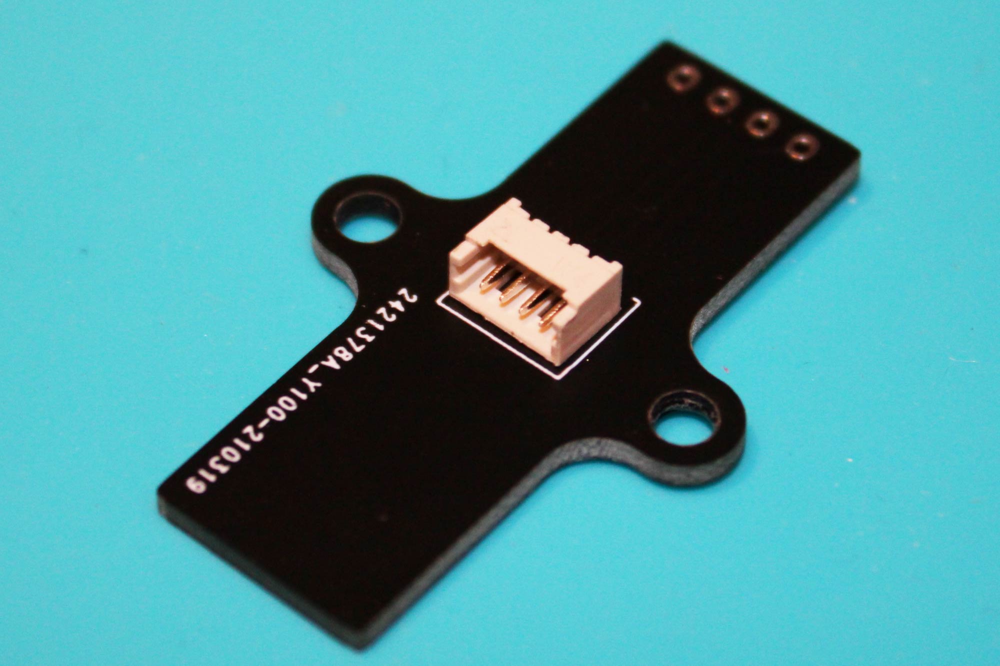
[picture p54: Assembly Guide/images/16_OLED_Conn_B.jpg]

</a>

Insert the 4 pin connector to the back of the PCB. Align it with the marking on the PCB and then solder each pin from the front.

### **Be sure to solder correctly in this step, as there will be no access to the solder joints once the OLED screen is in place.**

<a href="images/OLEDScreen_A.jpg">
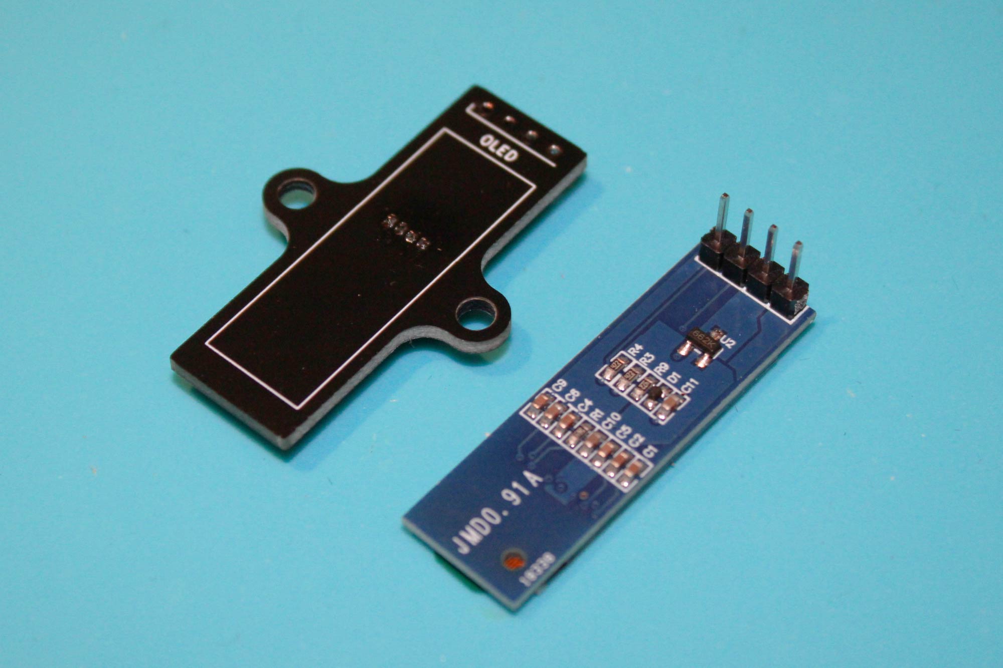
[picture p55: Assembly Guide/images/OLEDScreen_A.jpg]

</a>
<a href="images/OLEDScreen_B.jpg">
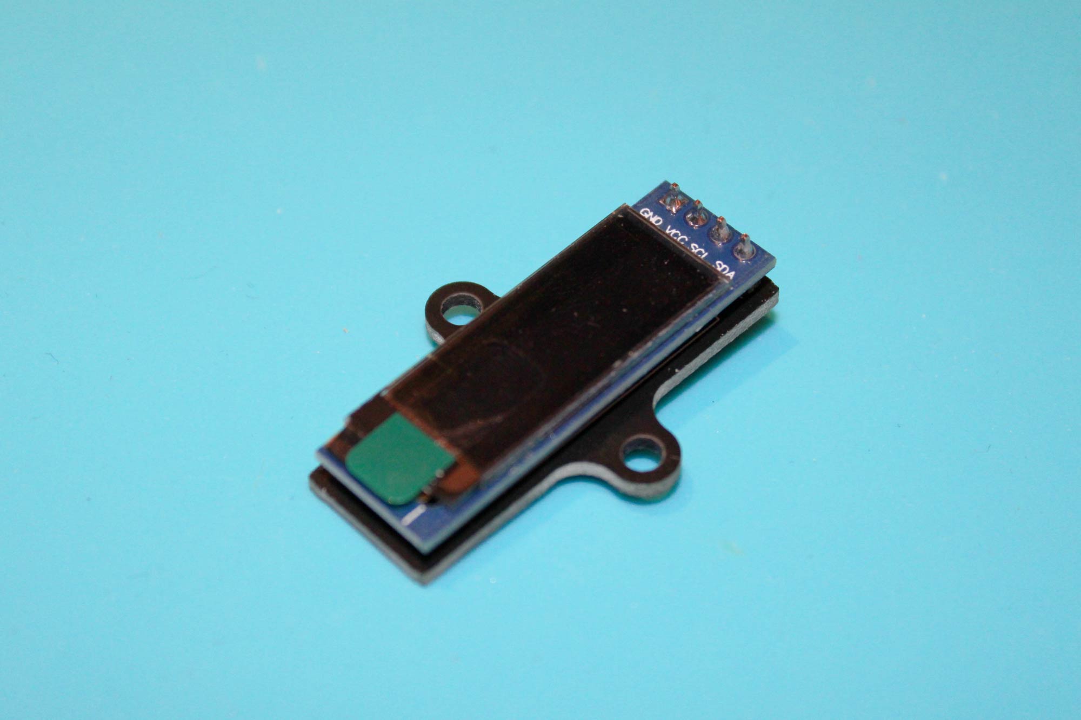
[picture p56: Assembly Guide/images/OLEDScreen_B.jpg]

</a>

Insert the short pins of the OLED screen header through the back of the OLED PCB then solder from the front. Then place the long pins of the screen header through the black mounting PCB and solder each pin from the underside.

<a href="images/17_OLED_Trim_A.jpg">
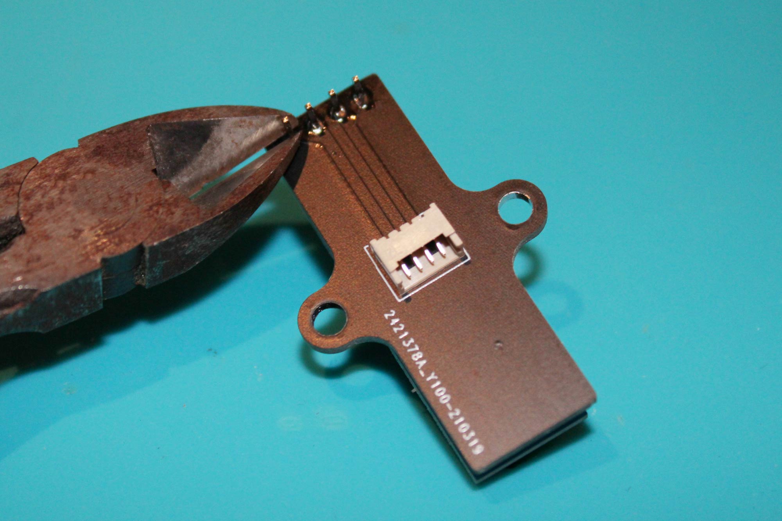
[picture p57: Assembly Guide/images/17_OLED_Trim_A.jpg]

</a>
<a href="images/17_OLED_Trim_B.jpg">
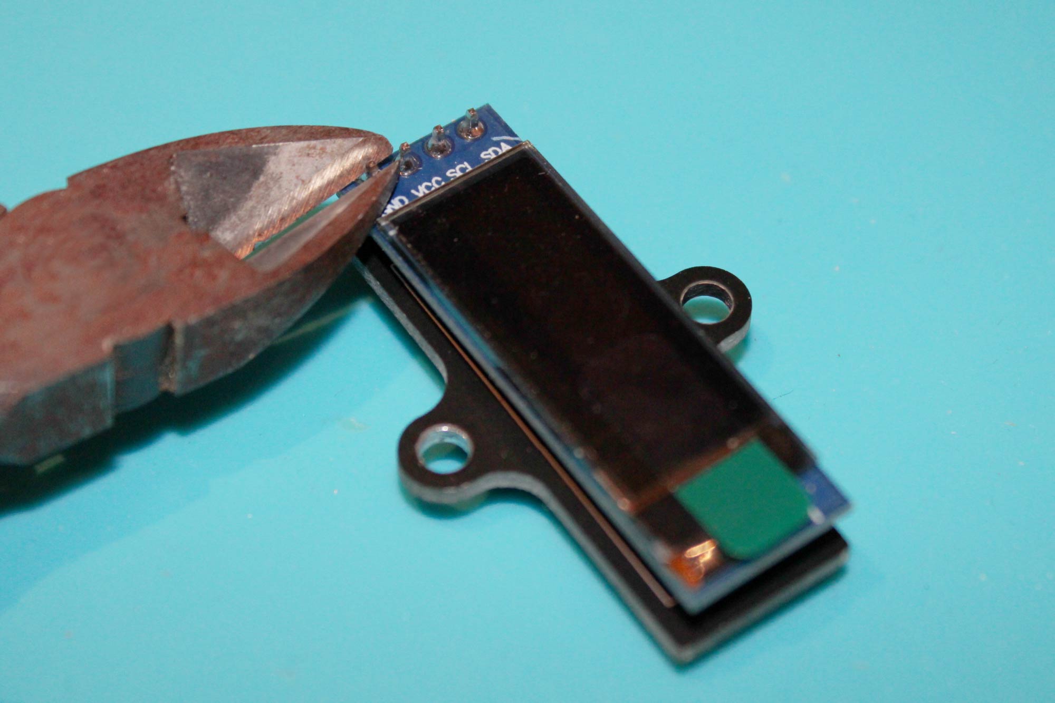
[picture p58: Assembly Guide/images/17_OLED_Trim_B.jpg]

</a>

Trim header pins short on both side. 

<a href="images/17_OLED_Trim_C.jpg">
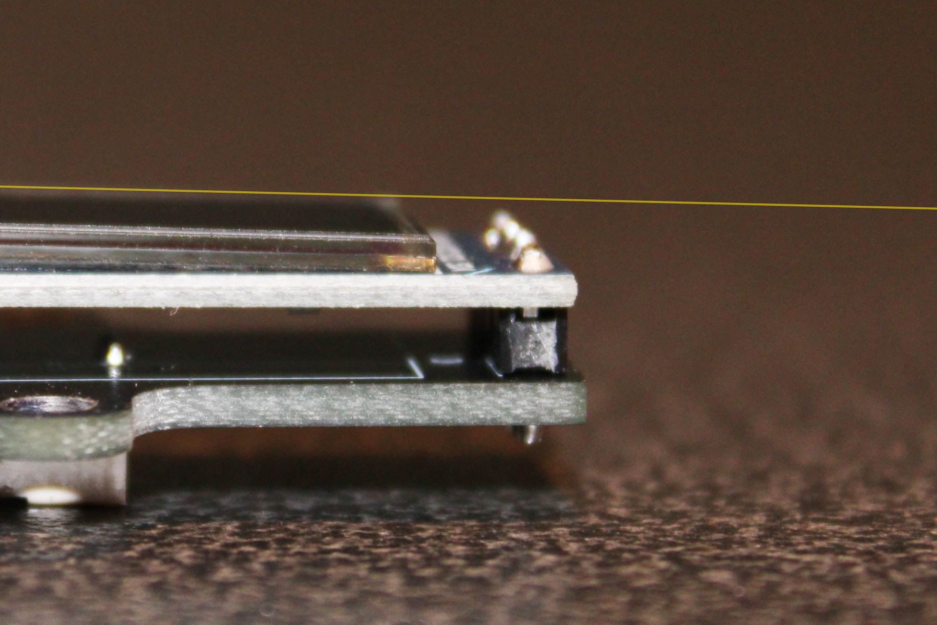
[picture p59: Assembly Guide/images/17_OLED_Trim_C.jpg]

</a>
<a href="images/OLED_Tilt.jpg">
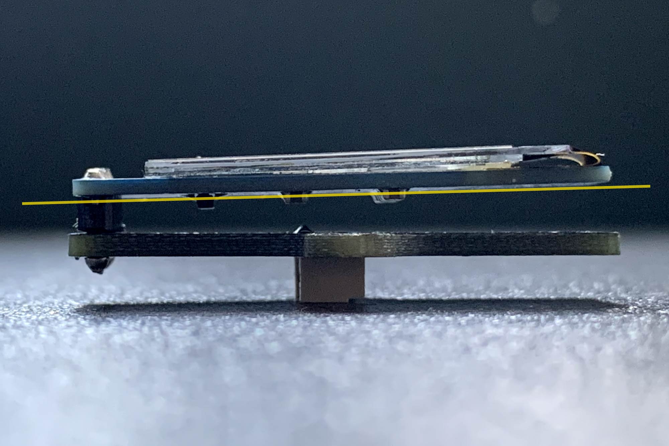
[picture p60: Assembly Guide/images/OLED_Tilt.jpg]

</a>

Be sure the pins on the front are not protruding higher than the screen. Also, tilt-up the OLED screen slightly. Otherwise, there will be a gap between the case and the screen.

<a href="images/18_OLED_Install_A.jpg">
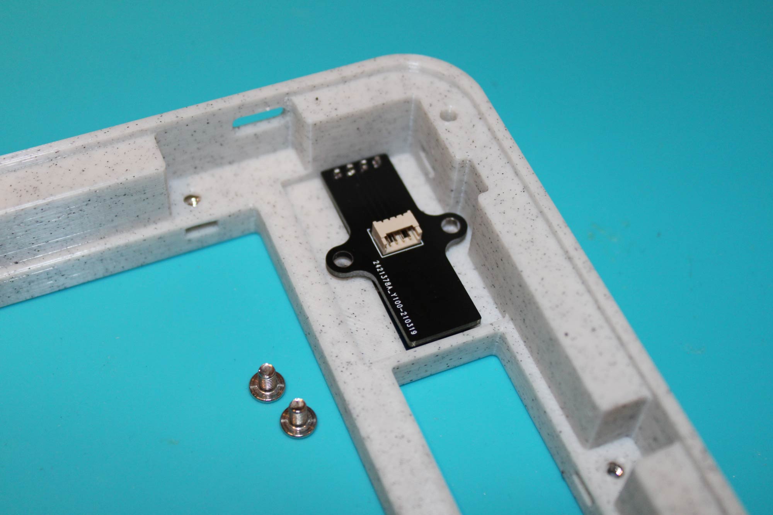
[picture p61: Assembly Guide/images/18_OLED_Install_A.jpg]

</a>
<a href="images/18_OLED_Install_B.jpg">
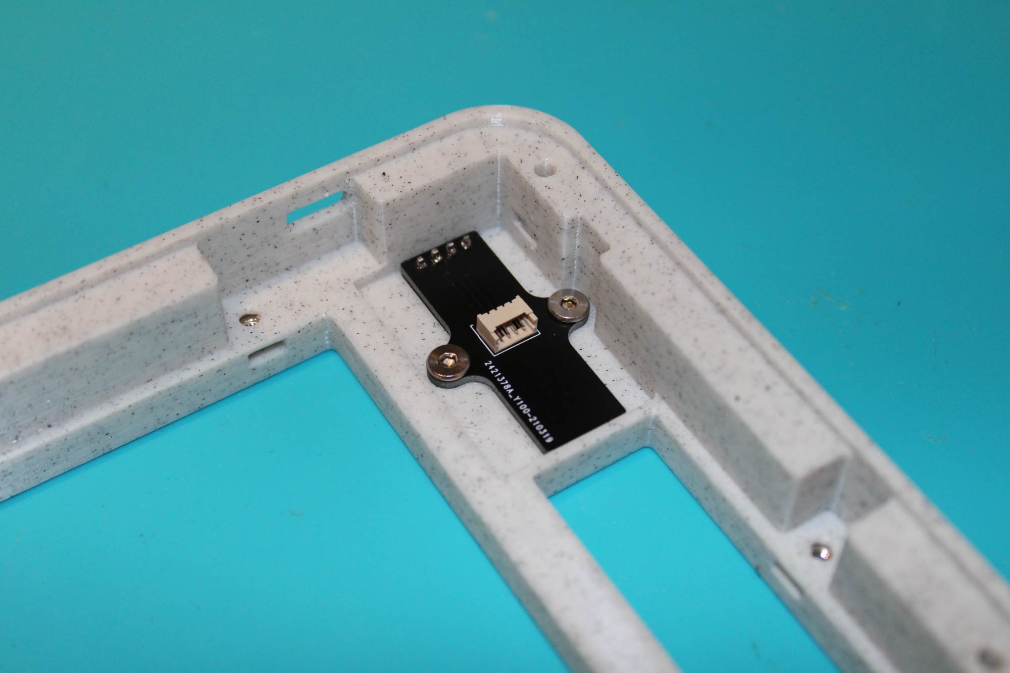
[picture p62: Assembly Guide/images/18_OLED_Install_B.jpg]

</a>

Attached the OLED screen to the left case with 2 M3 5mm screws.

> When mounting the OLED screen to the case, there will be resistance at first, as the square nuts insets underneath are not yet aligned, it will become smooth after that.
>
> <a href="images/PreScrew_A.jpg">
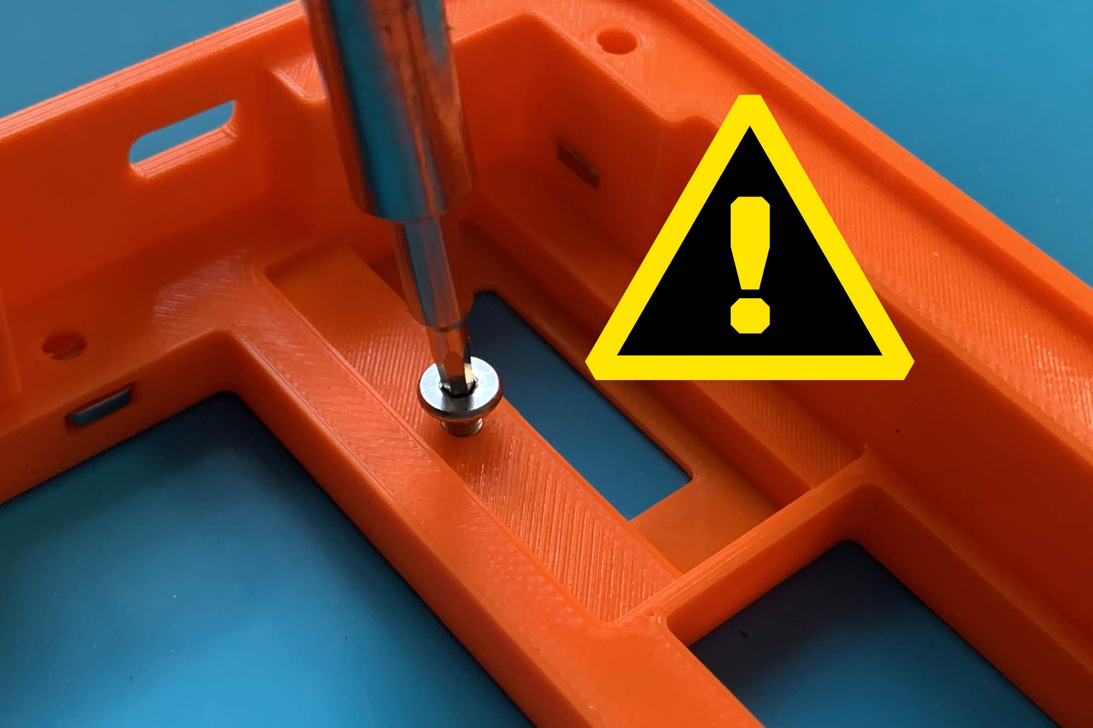
[picture p63: Assembly Guide/images/PreScrew_A.jpg]
> 
> </a>
> <a href="images/PreScrew_B.jpg">
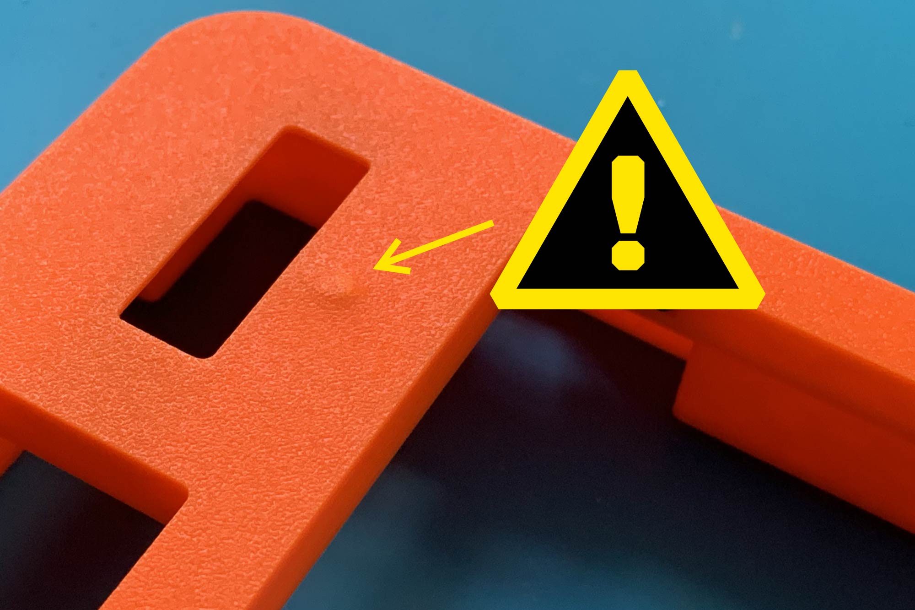
[picture p64: Assembly Guide/images/PreScrew_B.jpg]
> 
> </a>
>
> You can pre-screw all the mounting points without PCB to align the inserts before assembling.
> <span style="color:red"> **WHEN DOING THIS, BE SURE NOT TO OVER TIGHTEN, ESPECIALLY ON THE OLED SCREEN MOUNTING POINTS. OTHERWISE, SCREWS CAN PUNCTURE THROUGH TO THE TOP OF THE CASE.**</span>.

## **Mount PCB assembly to case**

<a href="images/Asm_mount_R.jpg">
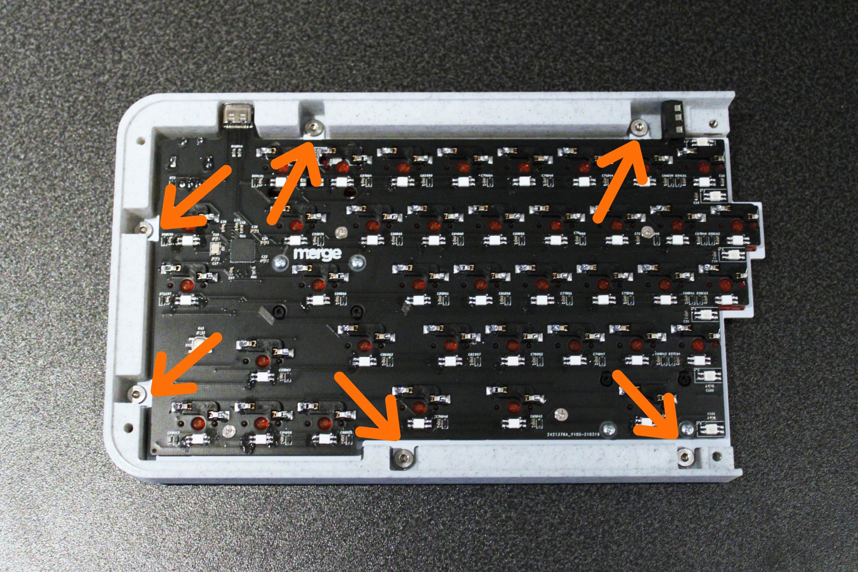
[picture p65: Assembly Guide/images/Asm_mount_R.jpg]

</a>
<a href="images/Asm_mount_L.jpg">
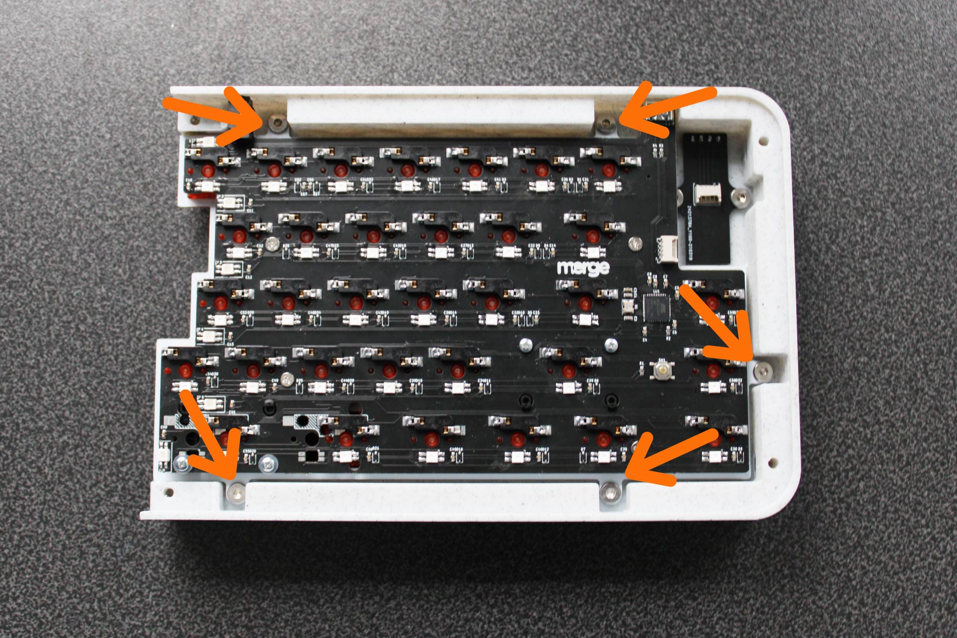
[picture p66: Assembly Guide/images/Asm_mount_L.jpg]

</a>

There are 5 mounting points on the left side and 6 mounting points on the right side.
Secure the PCB with the M3 5mm screws. There will be resistance at first, as the square nuts insets underneath are not yet aligned, it will become smooth after that.

> <a href="images/CaseAssembleEncoder.jpg">
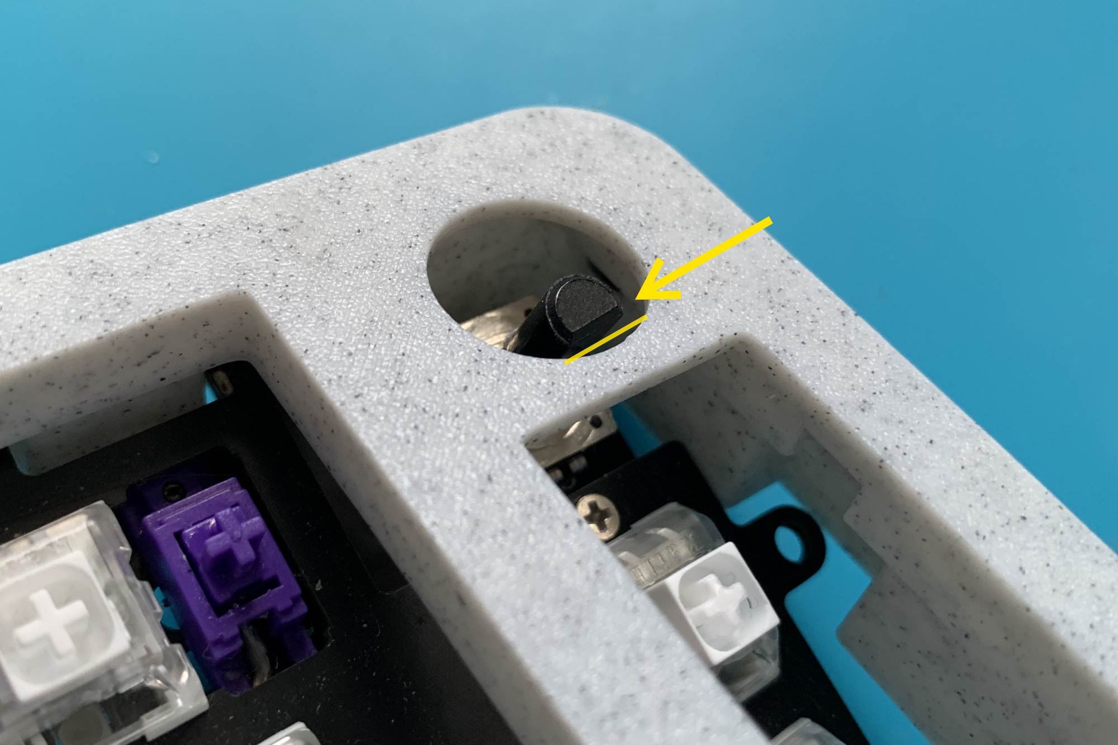
[picture p67: Assembly Guide/images/CaseAssembleEncoder.jpg]
> 
> </a>
>
>Before putting the right side PCB into the case, turn the encoder stam flat side face toward the bottom of the case for more clarence.

## **Connecting OLED screen**

<a href="images/ConnectOLED.jpg">
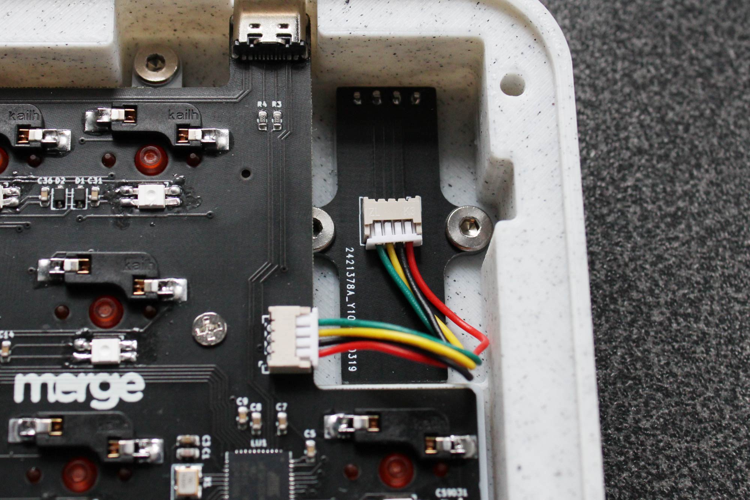
[picture p68: Assembly Guide/images/ConnectOLED.jpg]

</a>

Connect OLED screen with the 4 pin cable.

## **Case Assembly**

<a href="images/Case_asm_A.jpg">
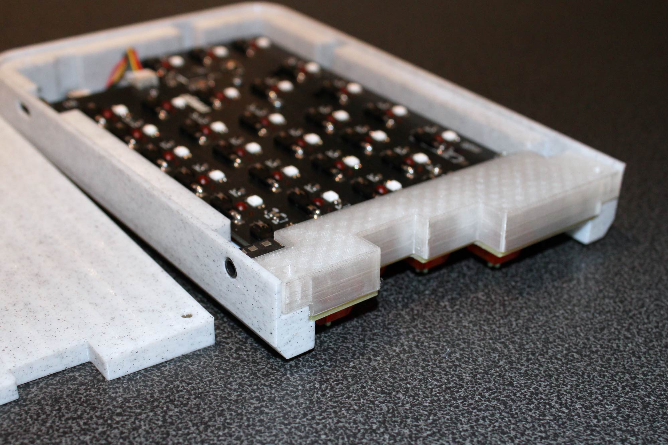
[picture p69: Assembly Guide/images/Case_asm_A.jpg]

</a>

Place the side panel and cover onto the case.
### **Default cover**

<a href="images/CoverScrews.jpg">
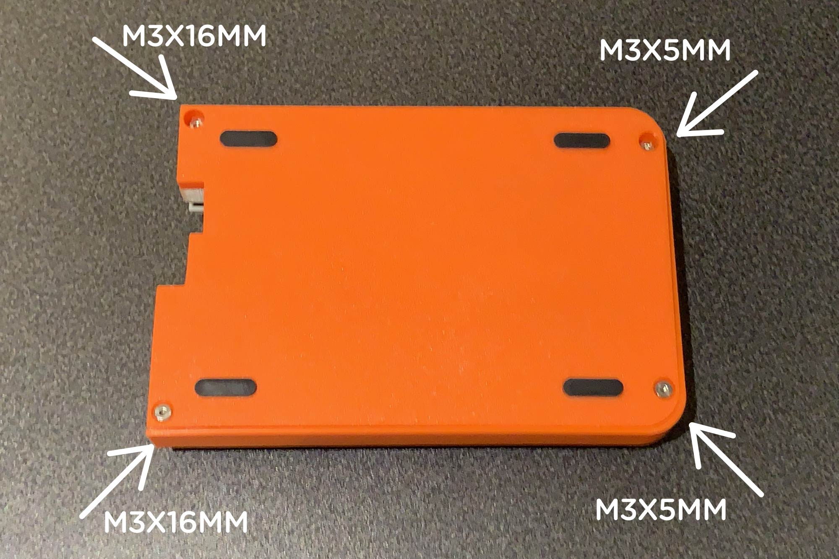
[picture p70: Assembly Guide/images/CoverScrews.jpg]

</a>

Fasten it with M3x16mm and M3x5mm screws.

### **With raisers**

<a href="images/RaisersScrews.jpg">
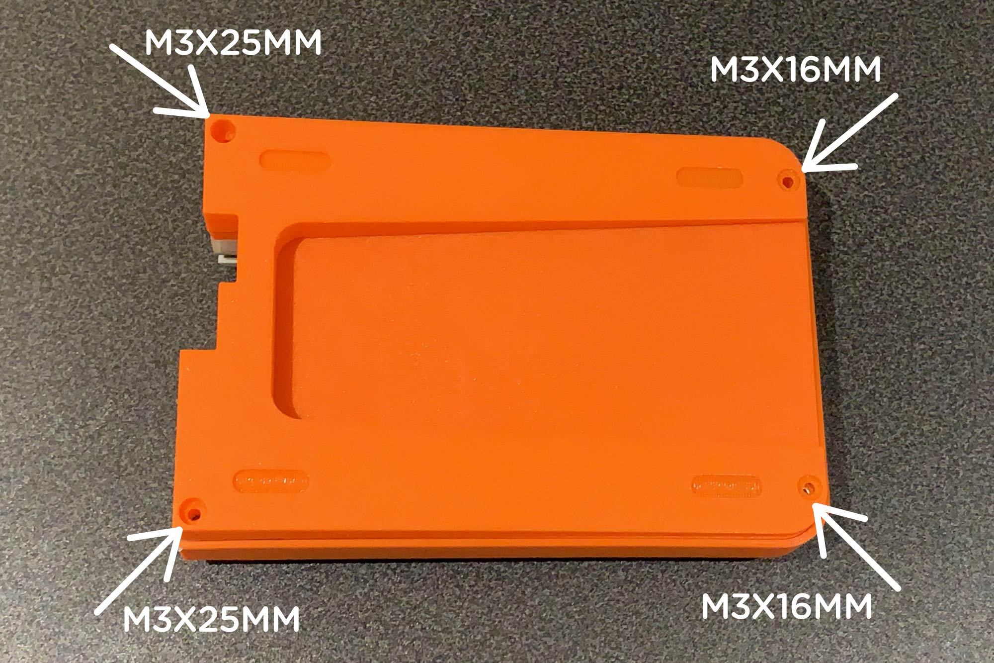
[picture p71: Assembly Guide/images/RaisersScrews.jpg]

</a>

Fasten it with M3x16mm and M3x25mm screws.

---
## **Done**

<a href="images/Done.jpg">
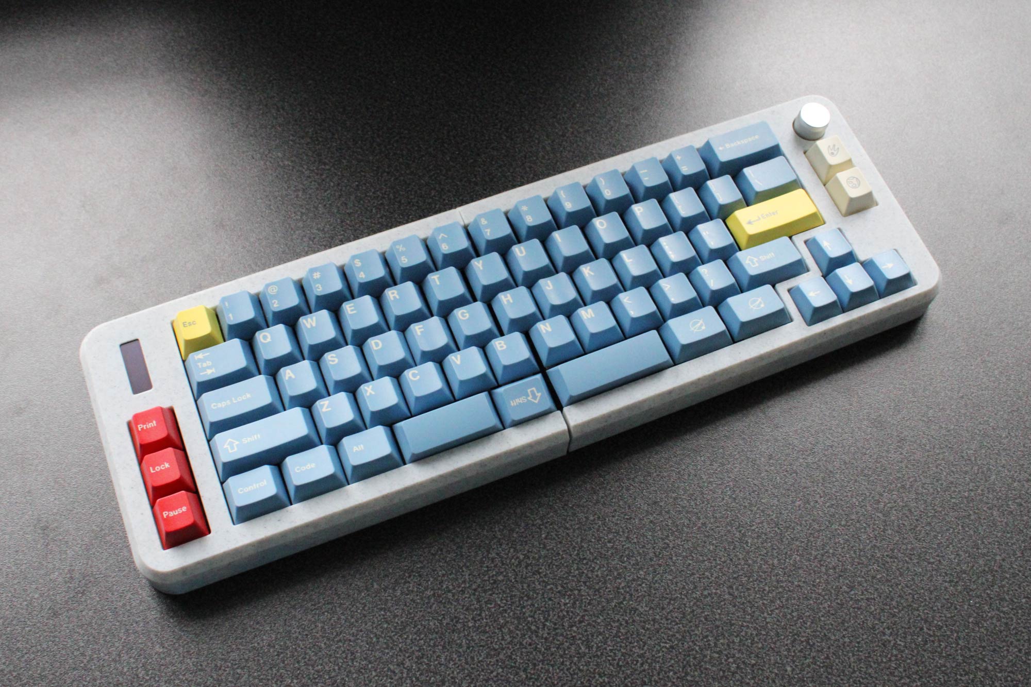
[picture p72: Assembly Guide/images/Done.jpg]

</a>

---
