duoshock/UM-70/Print Guide/readme.md

# **Print guide**

## **Print files**

There are 7 parts need to be printed in order to complete the build.
- Left & right cases
- Left & right covers
- Left & right panels
- Knob
- Risers (Optional)

## **Recommended print setting**
<a href="images/SP65_PrintOrientation.jpg">
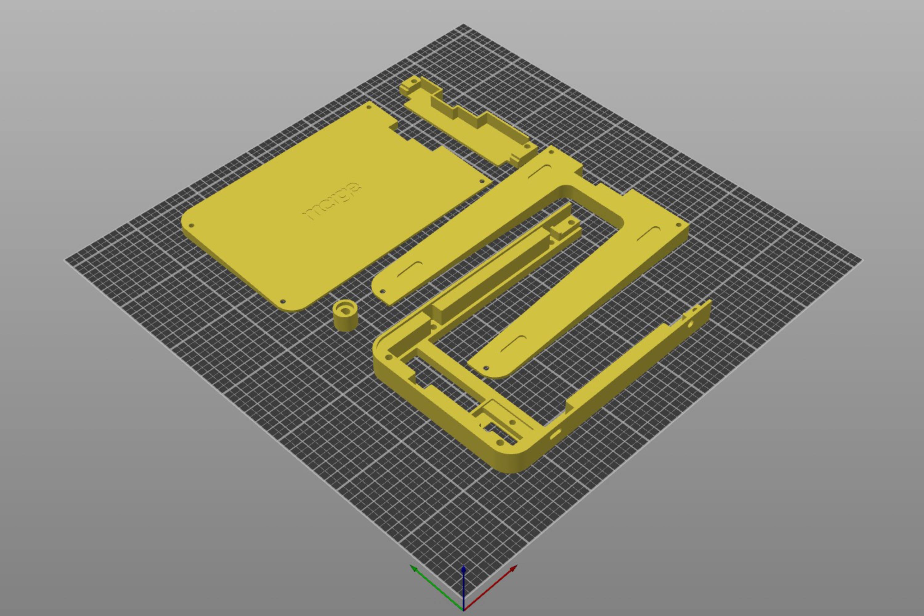
[picture p73: Print Guide/images/SP65_PrintOrientation.jpg]

</a>

Print Orientation

- Minimum build volume: 200 x 125 x 23mm
- 0.4mm Nozzle
- 0.2mm layer height
- ≥ 15% infill

All parts are designed to be printed with 0.2mm layer height without support, see print orientation.

## **Thread Inserts**
<a href="images/SP65_PrintInsert_L.jpg">
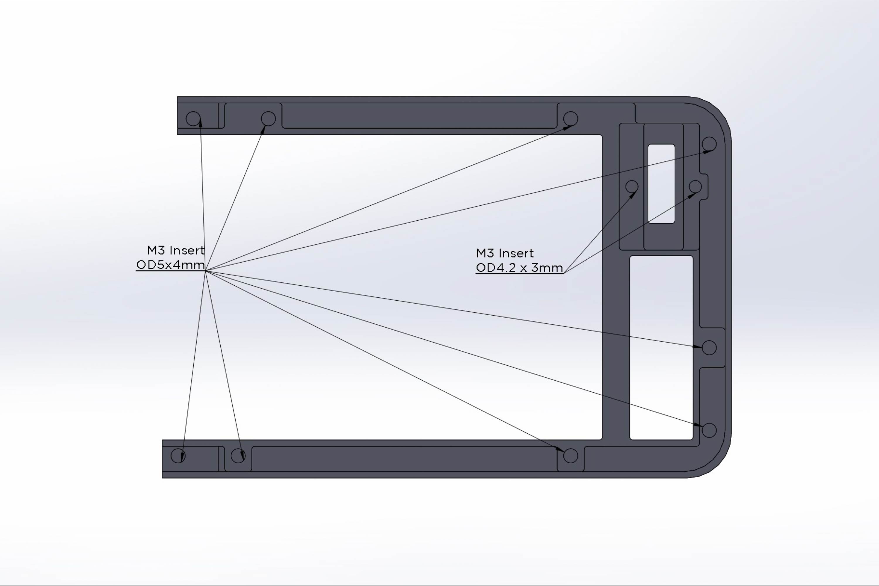
[picture p74: Print Guide/images/SP65_PrintInsert_L.jpg]

</a>
<a href="images/SP65_PrintInsert_R.jpg">
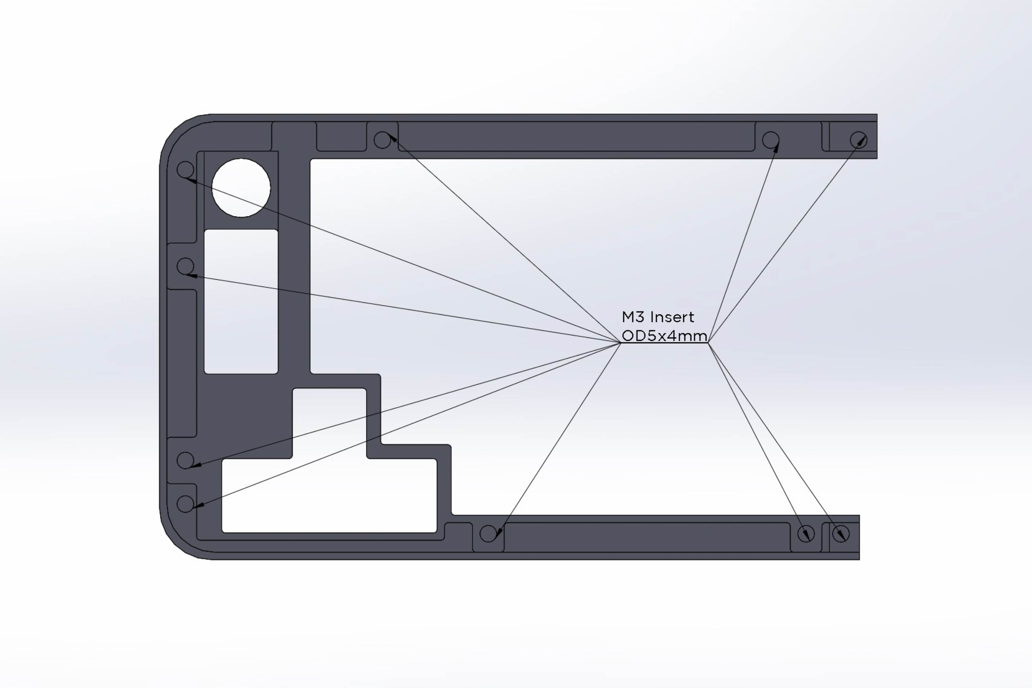
[picture p75: Print Guide/images/SP65_PrintInsert_R.jpg]

</a>

PCB kit comes with heat-set threaded inserts for both halves. All mount holes are designed to accept M3 OD5 x H4 except OLED mounts which is OD4.2 x H3. See above for details.
