duoshock/UM-70/Assembly Guide/images/10_TRRS_C.jpg

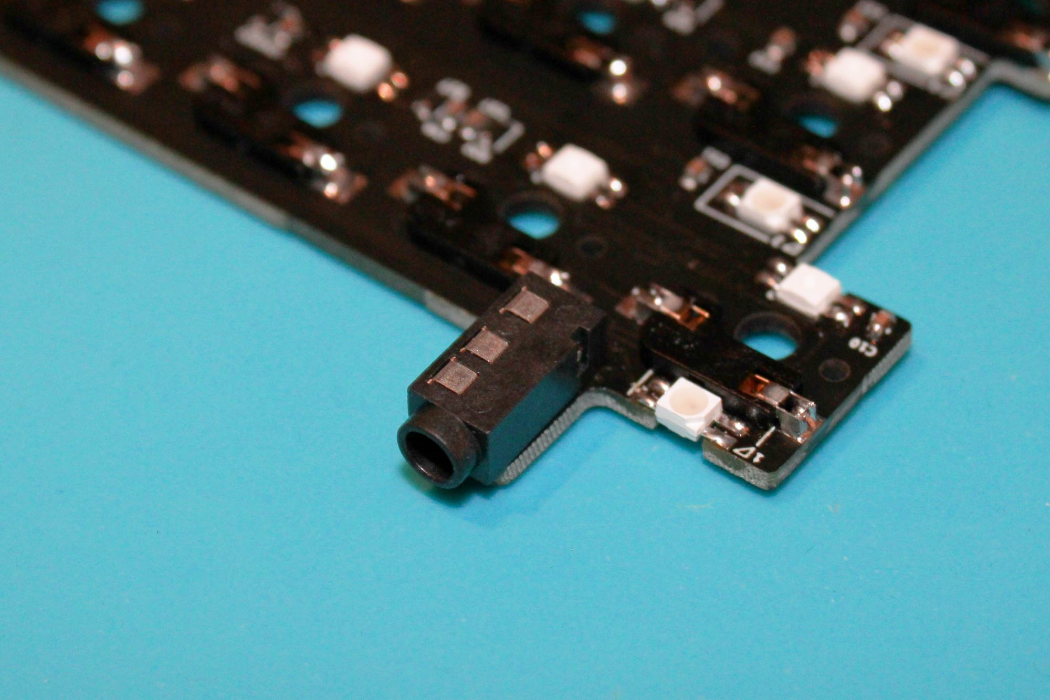
Assembly Guide/images/10_TRRS_C.jpg
