duoshock/UM-70/Assembly Guide/images/PlateMountL.jpg

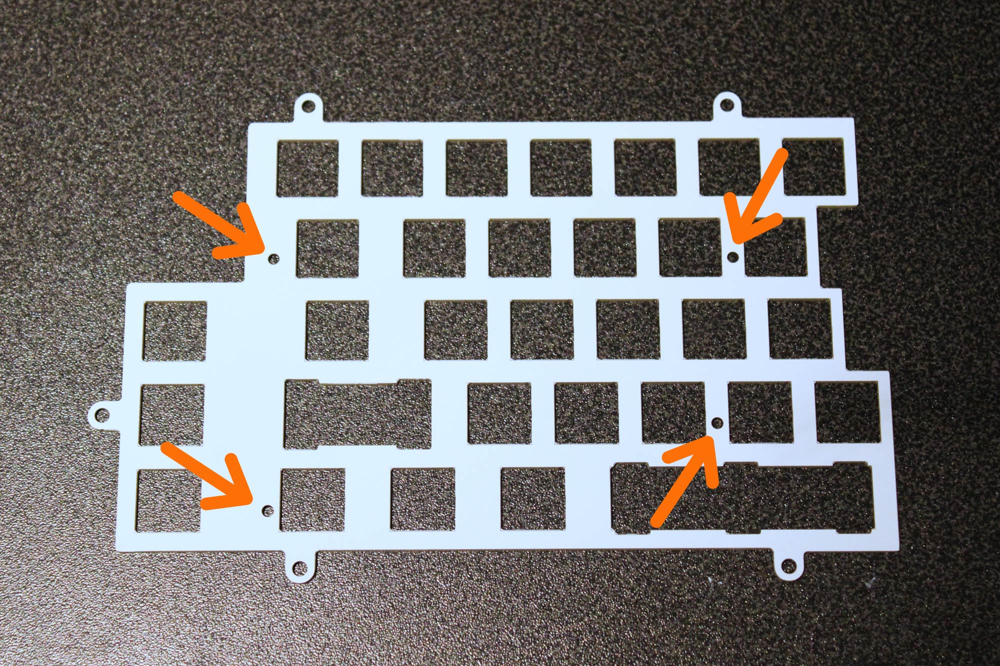
Assembly Guide/images/PlateMountL.jpg
