duoshock/UM-70/Assembly Guide/images/PlateMountR.jpg

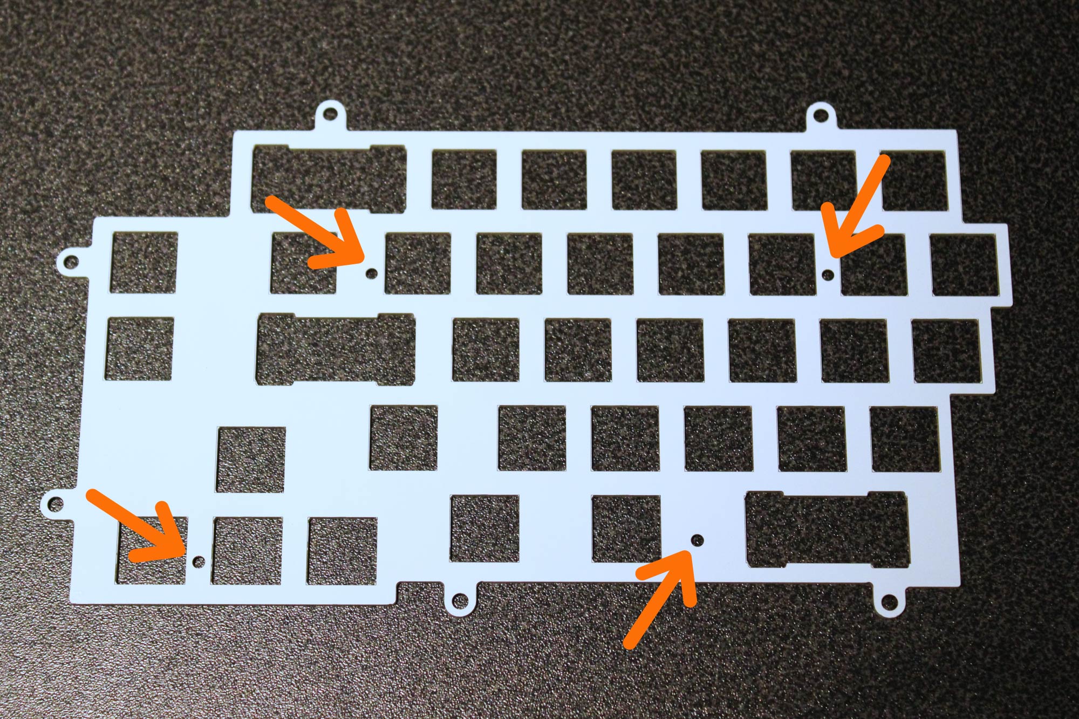
Assembly Guide/images/PlateMountR.jpg
