duoshock/UM-70/Assembly Guide/images/StandOff_A.jpg

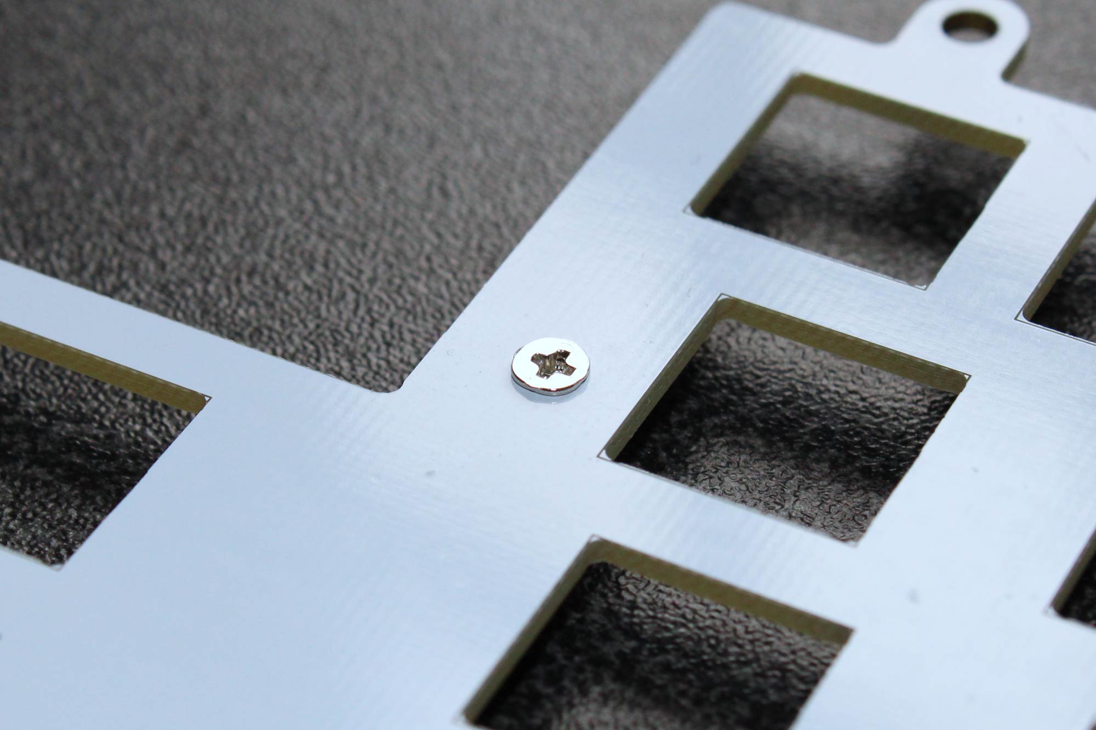
Assembly Guide/images/StandOff_A.jpg
