duoshock/UM-70/Assembly Guide/images/StandOff_B.jpg

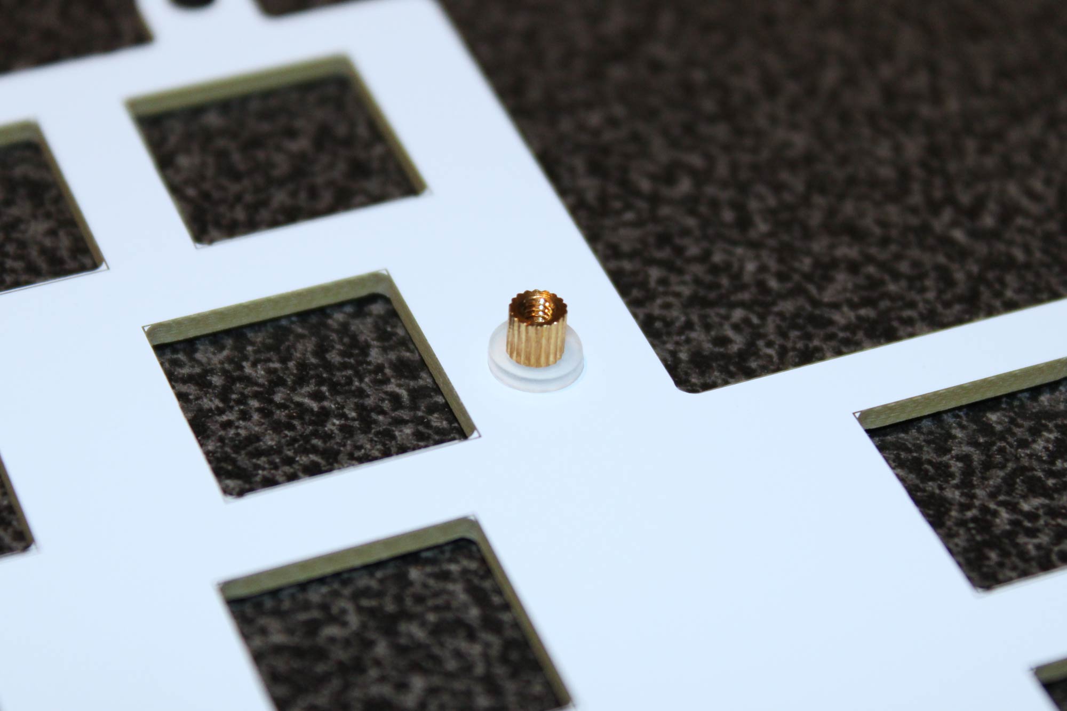
Assembly Guide/images/StandOff_B.jpg
