duoshock/UM-70/(threads)

Thread 3 (2025-07-29):

Knob STL missing

danseely, 2025-07-29:
Sorry if I'm completely missing something, but I don't see the STL for the knob in this repo, and I'd like to print a few in some different colors.
