duoshock/UM-70/(commit log)

2021-04-10 Create Assembly Guide.md
2021-04-10 Update Assembly Guide.md
2021-04-11 Assembly-Guide_v1.0.1
    Made spelling/grammar changes for clarity
2021-07-31 update PCB mount photo
2021-07-31 Update plate mount images
2021-08-01 Updated Assembly Guide.md
    Minor clarification for several steps
2021-08-01 Rename Assembly Guide.md to Assembly-Guide_v1.0.2.md
2021-08-01 Rename Assembly-Guide_v1.0.2.md to Assembly Guide.md
